visualapproach/Volvo-melbus/schematics/8645_4066.png

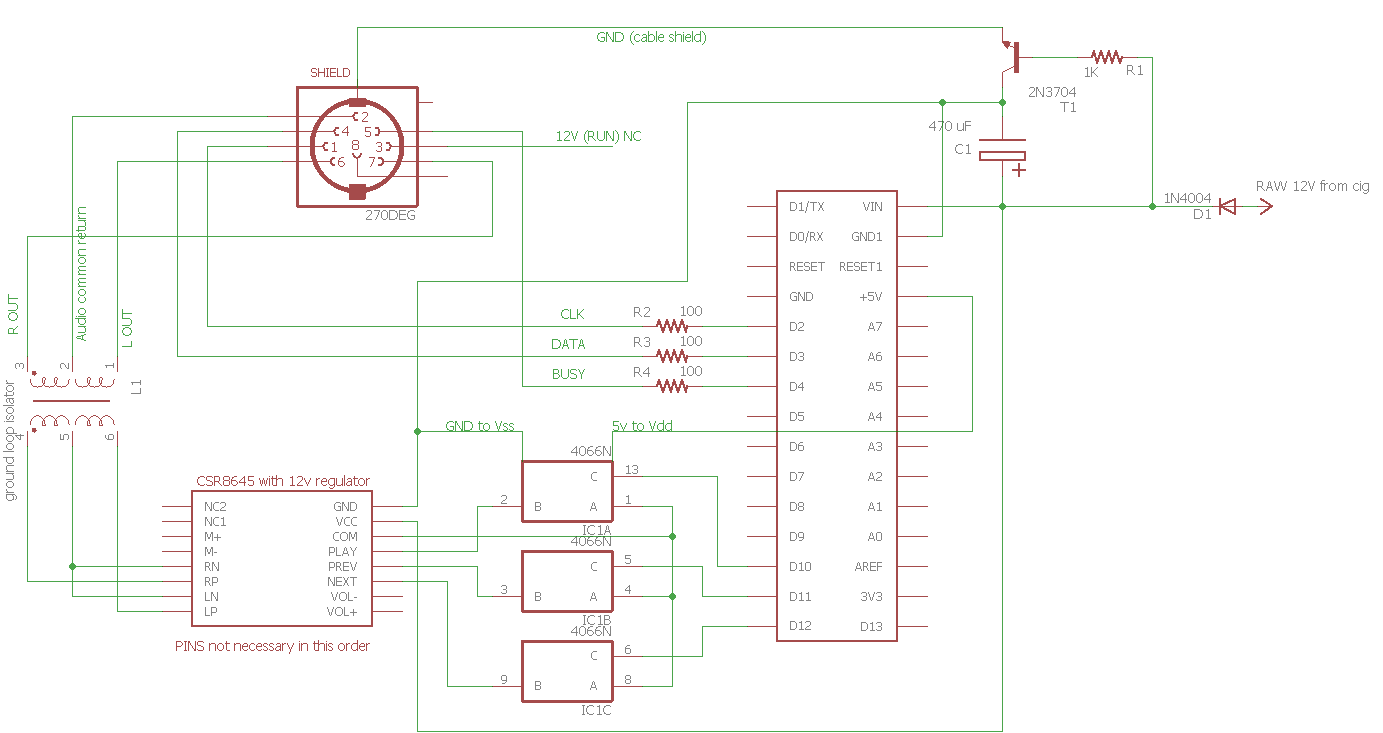
schematics/8645_4066.png
