visualapproach/Volvo-melbus/schematics/uln2003_2.png

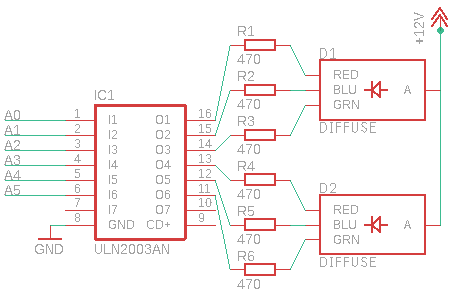
schematics/uln2003_2.png
