visualapproach/Volvo-melbus/(threads)

Thread 2 (2017-03-24):

Some noise present when BT audio is off.

visualapproach, 2017-03-24:
Data transmissions is audible when not playing. I have audio and data running in the same CAT5 network cable.

visualapproach, 2017-03-26:
It appears to be the arduino that is the source of the noise. (It goes silent when resetting the arduino. Remains if I disconnect the audio, wich suggests it is NOT a ground loop problem.) I'll try decoupling the power lines with a cap.

sorano, 2017-03-26:
Nice find!

Såg precis att du uppdaterade fotot, Lol @"fritzing" ;)

schematic.png visar pins 8, 11,12 för BT medans foyot & koden använder 8,9 & 12.
Ska se om det är mycket på jobbet imorgon annars kan jag börja klippa och klistra lite riktig fritzing :) som komplement till fotot.

Är det bakelit pcb du använder?

visualapproach, 2017-03-27:
Tack. Tyvärr hjälpte det inte med en konding. Angående pin-val så spelar det ingen större roll vad gäller att kontrollera BT-modulen (Däremot måste data-pinnarna hamna rätt för de använder interrupt som bara finns på vissa pinnar). Du bestämmer funktion genom att definiera pinnarna i början på koden.
Jag hade ett gammalt experimentkort liggande. Tror det är glasfiber eller liknande. Kopparn är rader om tre hål:
--- --- --- --- ---
--- --- --- --- ---
osv, men det går så klart med andra typer också.

visualapproach, 2017-03-28:
Glömde säga det, men det vore ju jättebra om du gjorde en riktig fritz. Kanske blir enklare för nästa person som vill vara med. Jag har nu åkt till jobbet några dagar och lyssnat på BT-musik. Riktigt nice! Ibland kopplar inte iphonen upp sig automatiskt mot modulen utan man får klicka på "anslut", men sen funkar det bra. Modulen spelar en liten plingplong när den ansluter.

sorano, 2017-03-28:
Har börjat skissa lite i Fritzing nu, ge mig nån dag så ska jag ha det någorlunda ok!

Vet du om BT modulen klarar av [aptX](https://en.wikipedia.org/wiki/AptX )? Har märkt av skillnad i ljudkvalité på BT jämfört med AUX?

visualapproach, 2017-03-29:
Jag har faktiskt ingen aning om aptX. Man måste nog kolla datasheetet för själva chipet och det är lite krångligt när den är i bilen för det behövs i princip ett mikroskop. Jag hör ingen skillnad mellan AUX och BT. Det är ju subjektivt men jag har inget att klaga på vad gäller ljudkvalitén. Jag är nöjd.

mrkiller2010, 2017-03-29:
Haha, sjukt hur jag hittat er som fortfarande kör runt dessa volvos! :) Har en Volvo V40 2001 fas1 med en HU radio.
Köpte en 8pin kabel till aux hona. Fick hem det idag och har inte hunnit att testa det, så måste man göra en interface och använda sig utav kod för att få auxen att funka? :/

Sorry för offtopic

visualapproach, 2017-03-29:
@mrkiller2010
Hej och kul att du hittade oss ;-)
enligt [denna sida](http://forums.swedespeed.com/showthread.php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) så har du en HU som använder MELBUS och dessa måste man lura att det finns en CD-växlare för att de ska öppna LINE-IN. Finns komersiella grejer att köpa, eller så har man inte vuxit ur "kansjälv-stadiet" och värmer upp lödpennan.
Det är ok med off topic, det finns ju ingen allmän chat man kan skriva i vad jag har sett.

mrkiller2010, 2017-03-29:
@visualapproach
Okej, nu är jag med. Men din lösning har även support för BT.
Skulle du kunna länka alla delar som krävs för denna interface? Finns ju alternativ till audrino, skulle det funka bättre?

Det [http://i.ebayimg.com/images/g/DKEAAOxym2BSGzav/s-l300.jpg](här) jag köpte. Fast med AUX hona så jag kan borra i den till själva radion

visualapproach, 2017-03-29:
@mrkiller2010
Först skulle jag testa bara sladden du köpt. Vem vet, kanske har den inbyggd elektronik. Fast jag skulle mäta på den först så du inte kör 12v rakt in i mobilen eller vad du tänkt koppla in. En av pinnarna på DIN-kontakten är nämligen 12v.
Om du ska bygga så läs [readme](https://github.com/visualapproach/Volvo-melbus/blob/master/README.md). Om du inte vill ha BT så ta bort följande komponenter:

3x 560Ω
3x LED's (To drop voltage and look cool)
BT Audio Module

Koppla därefter in ljudsladden till resp pinne på DIN-kontakten. [Länk till DIN pin layout](http://volvo.wot.lv/wiki/doku.php?id=melbus)
Ladda upp koden på Arduinon och så ska det fungera.

Angående Arduino: För att aktivera LINE-IN genom att emulera CD-C så fungerar Arduino (i motsats till vad vissa säger). Det finns så klart en massa andra alternativ, men det är till Arduino jag gjort programmet. Om det nu är Arduinon som orsakar det lilla störljudet innan man aktiverar ljudspelning så kanske det funkar bättre med nå't annat men det har jag inte provat.

visualapproach, 2017-03-30:
@sorano
Fick igång SAT som SOURCE. Det kan innebära en del bra saker...
[readme](https://github.com/visualapproach/Volvo-melbus/blob/master/README.md)

sorano, 2017-03-30:
Coolt 😮 !

Vad står SAT för i detta fallet? Jag antar Satellit då det står Sirius? Varför vill man ens ha tillgång till satellit i sin bil? För satellit telefon? Eller TV om man har skärmar?

Hoppas du hittar något intressant 😃

visualapproach, 2017-04-01:
I got rid of 90% of the noise by driving the AUX (on the BT module) to GND via two resistors (Between 100 and 600 Ohms would be fine. I tried with 240 Ohms)
red---resistor---black---resistor---white
Good enough for me, so case closed.

mrkiller2010, 2017-04-30:
Undrar om du kan löda ihop allt om man beställer hem alla delar hem till dig för en slant?

visualapproach, 2017-05-07:
@mrkiller2010 Det blir inte lönsamt för någon av oss. Skillnaden mellan en kommersiell produkt och denna är bara några hundralappar som ska täcka både jobb och frakt.

mrkiller2010, 2017-05-09:
@visualapproach Hejsan!
Har precist beställt allting som du skrivit på listan, var tvungen och köpa flera stycken på vissa som resistor, LED, och dom där små sakerna.

Skulle du kunna skicka flera bilder på bygget? Vill se hur allt är lödat fast. tack

mrkiller2010, 2017-05-09:
@visualapproach Förresten, vad heter den där gula plattan allt sitter på? lär ju beställa en sådan också?

visualapproach, 2017-05-10:
@mrkiller2010 Det är en experimentkort. Det finns massor olika modeller och det spelar ingen större roll vilken du köper. Det finns billiga i papper med koppar på baksidan, men de är lite jobbigare att löda. Sen finns det lite dyrare i bakelit/glasfiber etc. Sök på "prototype experiment pcb" så hittar du massor. Ta en modell med 0.1" hålavststånd (2.54 mm) och som har tre-fyra hål per "ö". Dvs kopparn förbinder tex tre och tre hål. Då är det lättare att löda fler kablar till samma PIN osv. [exempel](http://www.ebay.com/itm/10Pcs-DIY-Prototype-Paper-PCB-Universal-Experiment-Matrix-Circuit-Board-8-5x20cm-/131047274580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)
Angående bilder på bygget så har jag monterat allt i en plastlåda som är jobbig att skruva isär. Är det nåt specifikt du vill veta så kan jag nog förklara.

visualapproach, 2017-05-10:
Ett tips när du bygger ihop allt: gör en anslutning så att du kan ta loss modulen utan att behöva demontera bilradiopanelen varje gång. Som du ser på mina bilder har jag ett antal små kontakter (kräver specialtång för att crimpa dit på kablarna), men man kan också skarva nätverkskabeln med tex en hanDIN+honDIN.

mrkiller2010, 2017-05-10:
@visualapproach Hejsan. köpte det du länkade precis.
Det jag undrar är hur allt är lödat, typ vilka kablar osv men det löser sig nog när jag får hem allting.
Detta är enbart bluetooth eller hur? Såg att du skrev att man kan enkelt koppla aux till blueetooth enheten och fixa det på det sättet?

Och vad menar du med att fixa en anslutning? Jag ska ju löda ihop allting och slänga in allt i en liten låda med sladd ut till själva MEL Bus porten till radion?

visualapproach, 2017-05-11:
@mrkiller2010 Hej, AUX ska bara vara att plugga in med medföljande sladd. (Minikontakt i BT-modulen som slutar med lösa kabeländar, så du kan koppla på valfri AUX-kontakt.) Med anslutning menar jag att skapa ett enkelt sätt att koppla loss plastlådan. Säg att du måste löda om något, då är det enklare att koppla loss boxen och gå och löda, än att riva ut stereon för att koppla loss den. Och bättre än att sitta i bilen och löda ;-)
En annan grej du kan tänka på (som står i schematics) är att jag blev av med det sista oljudet genom att INTE koppla in AUDIO GND. Lycka till med byggandet!

mrkiller2010, 2017-05-12:
@visualapproach Tackar för tipsen. Har du lyckats fixa custom text? Skulle vara coolt om man kunde ändra så att det står låtens titel eller BT/AUX på radion.

visualapproach, 2017-05-17:
Det vore jättecoolt men jag har inte forskat något mer. Det krävs nog att man sniffar en satellitradio för att lyckas. Lite svårt att gissa sig fram.

mrkiller2010, 2017-07-05:
Hejsan!
Har fått hem allting och jag har börjat löda ihop modulen.
Är inte riktigt klar men undrar vart två tråds sladden som sitter i BT chipet ska lödas fast samt.

Tror dessutom att jag lött helt felt men vi får se..  :/

visualapproach, 2017-07-05:
Kul! Du ser på bilden i readme vart den ska sitta i bt-modulen. Observera fel färgkod på sladdarna, så svart=+12v och röd = gnd. I alla fall är det så på min. Andra änden: svart direkt på Vcc(12v) och röd (gnd) på transistorns kollektor. Lägg upp ett foto eller skiss här om du vill ha stöd innan du kopplar in.

mrkiller2010, 2017-07-05:
Är trött på skiten haha.
Har du lust att hjälpa till med lödningen? är i stort sett klar, bara nätverkskabeln till 8pins anslutning samt till själv arduino och bt chipet kvar.

mrkiller2010, 2017-07-05:
Såhär långt har jag kommit, http://imgur.com/a/F5gko Det är säkert helt fel komponenter jag använt samt lödat fel haha.
Ska försöka löda ihop resten imorgon och se om skiten fungerar vilket jag tvekar på.

mrkiller2010, 2017-07-06:
Fan det är omöjligt o få nätverks sladdarna på 8pins skiten, råka smälta skiten så pinsen e sne nu :/
Har en till 8pins connector men vill ej göra den då jag inte kan. Sen så fattar jag ej hur jag ska ansluta nätverkskabeln till själva bt modulen o det.

har du inte lust o hjälpa mig om jag skickar allting hem till dig?

visualapproach, 2017-07-06:
Var bor du?

mrkiller2010, 2017-07-06:
Bor i Gävle

visualapproach, 2017-07-06:
Ok lite för långt. Jag jobbar men skriver mer ikväll. Som tröst kan jag säga att jag också smälte den första kontakten. Man får vara snabb och inte ha för hög värme eller för stor lödspets. Det bästa är om man har den inkopplad i en hona så stiften sitter fast medan man löder.

mrkiller2010, 2017-07-06:
Hur många timmar ifrån mig bor du om man åker med bil?

visualapproach, 2017-07-06:
6-7 skulle jag tro

mrkiller2010, 2017-07-06:
Kan annars skicka hem allting till dig, och du hjälper mig med det som är kvar? Står för porto och allting.

visualapproach, 2017-07-06:
Hann tyvärr inte kika på detta ikväll men ska göra det så fort jag får tid.

visualapproach, 2017-07-08:
@mrkiller2010 vilken email har du?

mrkiller2010, 2017-07-08:
@visualapproach dyar.98@hotmail.com

Closed 2017-04-01.

Thread 3 (2017-03-24):

HU is commanding power on repeatedly

visualapproach, 2017-03-24:
This isn't a problem, but annoying when sniffing the data line.

sorano, 2017-03-30:
Jag funderade lite på detta.
Kan det inte vara så att HU vill ha någon typ av "ack" acknowledgement som verifierar att enheten den söker är igång, och då slutar skicka HU skicka "power on"?

visualapproach, 2017-03-31:
Jo det är helt riktigt. Själva "powerup"-meddelandet ska ackas med en byte. Jag har provat alla svar (0-255) utan att märka skillnad. Tror att man måste hitta rätt i antingen CartridgeInfo (6 bytes) eller i TrackInfo (9 bytes). Det är dock lite jobbigare att testa brute force på så många bytes. (6 bytes = 256^6 = 281 biljoner kombinationer. Trackinfo är lite färre okända bytes.) Men när jag orkar tänkte jag göra ett mer interaktivt program så jag inte behöver kompilera om för varje ny kod, och så kan man kanske få fram betydelsen av fler bytes.

visualapproach, 2017-03-31:
Actually, I found an answer here on github. Maybe. I'll have to check...

visualapproach, 2017-04-01:
The answer was found here: [code](https://gist.github.com/klalle/1ae1bfec5e2506918a3f89492180565e)
Case closed

Closed 2017-04-01.

Thread 5 (2017-03-24):

Back powering through audio GND

visualapproach, 2017-03-24:
Need to think of a way to block back powering through audio GND. Not a big deal, but it's annoying that the arduino power led is glowing faintly when car is off.

visualapproach, 2017-03-26:
Solution: ground loop isolator.

Closed 2017-04-01.

Thread 6 (2017-03-27):

AUX & BlueTooth?

sorano, 2017-03-27:
What would be the best course of action if you want to use an AUX connector along with BlueTooth?

Connect AUX to the BlueTooth module or piggyback the cables to DIN?

visualapproach, 2017-03-27:
I'd connect it to the AUX on the BT module. It's supposed to automatically switch to AUX input when BT is quite (or not connected. The "manual" is sparse to say at least.) There is also a MIC input on the board, that I guess could be used to speak on the cellphone. I have a VOLVO corded Telephone installed so I haven't tested it :-D

sorano, 2017-03-27:
Will try and report once I get my module.

mrkiller2010, 2017-05-10:
@sorano Hello, Did you manage to get AUX input working as well?

Closed 2017-03-27.

Thread 10 (2017-07-11):

chat

visualapproach, 2017-07-11:
put your comments or questions here

visualapproach, 2017-07-12:
Check the cables extra carefully that comes with the BT Module! Red and black power wires may or may not be reversed. I've seen both...

rysatko, 2017-10-17:
Hello Thomas.
First of all I would like to thank you for your work. This is awesome project.
I tried to make my own dongle (for now only AUX-in, CSR8645 is on the way from china). But I managed to work it only once - both SAT and CD-CHGR. Then it showed SAT ERROR and since that time my HU850 (with 6CD built in) does not recognize it. I tried all your SW versions and also SW from Vincent, but no luck. Could you please go through the troubleshooting with me? When I open serial monitor, it tells only "Calling HU" and then plain lines only. After uploading Vincents SW it tells "not in sync".
HW side should be fine. I measured all connections several times and everything is OK.

visualapproach, 2017-10-17:
Hi and thank you for joining!
My first guess would be the power supply. The car electric power is very noisy and that can cause problems. I had some communication errors too when I switched from using the RUN wire as power supply to using 12v from the cigarette lighter. It was solved by NOT using the cig lighter as a GND-point, but using the shielded cable's shield. See picture below. The reason I didn't use RUN is that it couldn't deliver enough amps for my project. At least not consistantly. In the pic below I haven't included protection against backpowering. It can be done with a resistor and a transistor (see master thread) or several other ways. I really recommend the ground loop isolator also. It is worth the money (I think 20 €-ish)!

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

rysatko, 2017-10-17:
For now my HW is built exactly iaw the drawing in master thread. So I am taking +12V from RUN and it is grounded by pin #2. Plus I added 8205 voltage regulator because the regulator on my chinese Arduino seems a bit crappy and I measured only 2V on the 5V pin. So I hope that the solution is so easy as you suggest. I will let you know asap. :)
Btw. ground loop isolator is also on the way.

visualapproach, 2017-10-17:
Fingers crossed :-)
I think you could try to power it with a powerbank via USB. (Easier than resoldering stuff for a test)

I wonder if it's the voltage regulator or if RUN is not coping...

rysatko, 2017-10-17:
So it is connected to the lighter socket. But no change for now. I am taking my computer to the car and we will see..

rysatko, 2017-10-17:
Nothing again. HU does not recognize it. :(

visualapproach, 2017-10-17:
Ok... did you try driving the arduino from the computer ONLY? (Disconnect 12v cig and 12v  RUN, and connected GND through DIN cable)

visualapproach, 2017-10-17:
Do you get any text except "calling HU"? If not then I suspect the main init sequence is not performed successfully. Maybe it doesn't pull the busy line low enough? And confirm your arduino is 5v 16MHz. The 3.3v 8 MHz won't do. It might be helpful if you post some pics on your device.

rysatko, 2017-10-17:
I am sure, that it is 5V arduino. As I told you, it worked for 2 days. I can see text "calling HU" in serial monitor. Now I am going to desolder GND and take it to car again, this time powered from powerbank only.

visualapproach, 2017-10-17:
Ok. It can be really frustrating and take a lot of time finding what's causing the trouble. But since it has worked something must have happened. Which means it is not likely software. So either something broke physically or electronically. Several times I have been certain it was a bug in my program, but it always ended up beeing a loose wire, or bad ground or similar. It's difficult to say what's wrong in your case and all I can offer at this point is some generic recommendations:
-check voltages and resistances with a multimeter (like is 12v OK even when under load? Same for 5v. Is GND resistance to HU chassi almost 0 Ohms? Recheck DIN connector, it's prone to bending and in a tight space there is a risk of shorts.
-make another visual inspection of the cables. Look for shorts or open circuits in the cables and under/over the PCB.
-do not use extremely long wires/cables.
-when in doubt, reduce to simplest possible circuit and check functionality. (only arduino, powered from battery)
-get a couple of beers and sleep on it. Repeat this step if necessary.

rysatko, 2017-10-17:
The last step would be the best :D
No succes with power only from USB. Only "conn" or "calling HU" messages.
To go through hints you gave me:
- Resistances checked, everything is fine. Voltages not yet, only on table when powering it from 12V PC power source - was ok. Bending of DIN is not my case, because I am trying it with HU pulled from dashboard.
- I have done inspection for shorts with ohm meter - ok
- Longest wire is approx 0,5m cable to DIN and 1,5m audio cable (does not matter)

Maybe I can try to buy another Arduino and try it again.

When I think about it, I have bought AUX/USB/Bluetooth box from china and I also had issues with it. Sometimes it worked, but mostly not. This was why I wanted to build my own. Maybe my HU constantly has its days. :/

visualapproach, 2017-10-17:
Yes maybe it's the HU, I have a 650 myself. No play in the HU connector? If you wiggle it I mean. Anyways, you should see almost 5 v on the data/busy/clk-lines at the arduino side when you measure, and 12 v on RUN. If you don't, you know the problem is either your HU or the cable. If possible you should measure this first with arduino disconnected (because it pulls the lines high) If this is too cumbersome you can upload a sketch that tristates D2-D4 (pinMode(2, INPUT))
I really wish you good luck now, and keep us updated on your progress!

rysatko, 2017-10-17:
I will try the code with input pins on D2-D4, because Arduino is soldered to prototype board and it would be pain in ass to get it off. I can also build second cable, but it is nonsense. I will try it on Thursday (if I will not be in work till night :D ).
Also the Arduino could be bad. As I told you, the voltage converter on it is quite tricky and when I powered it directly from 12V, the LEDs on it lit only slightly. That time when I powered it with 5V from NTB or via 8205, it worked like a charm.

Thanks so much for your time and kindness. I really appriciate it. ;)

rysatko, 2017-10-28:
Hello again.
I finally tried it. I'm not at home and I forgot to take USB cable to upload modified software so I tried to disconnect GND cable from the whole box (in my opinion it should work too, but maybe I am wrong). I have got 3V on D2 and D4 and 4,5V on D3.

visualapproach, 2017-10-28:
Hi again! Hang on and I'll check what my DIN output measures at the end of the cable...

visualapproach, 2017-10-28:
Yes, As I suspected I measured 4.7 volts at all three lines (In car, arduino end of cable, disconnected from arduino. I have an extra pair of DIN plugs so I can easily remove the device from the car). So I think you've traced it to be either your cable, or your HU. Next step would be to remove the cable and measure on the HU itself.

rysatko, 2017-11-04:
Finally a day off - HU measured. RUN - 11,26V, DATA and CLK - 4,57V, BUSY - approx. 4,5V (fluctuating between 4,42V and 4,58V. Now I will try to desolder the cable from my board and try it again. The cable is 8x0,25mm2, connector is standard solderable 8-pin DIN 270°.

visualapproach, 2017-11-04:
Good! It is a good thing that your HU is healthy. It is much easier to fix the cable. I use a shielded network cable with 4 twisted pairs in it. I had to run GND through the shield, rather than the GND at the cig connector, to get rid of alternator noise. (See image in this thread). I wish you luck!

rysatko, 2017-11-04:
Connector checked and soldering is rock solid. So I desoldered BUSY, CLK and DATA at the side of Arduino and measured once again. And I found out, that when I move with the cable at the HU side, voltage of BUSY is droping to 0V. This is a hope :)

visualapproach, 2017-11-04:
Yay! Bad wire? Great find! Intermittent faults are tricky to hunt down.

rysatko, 2017-11-04:
I changed the wire aaand... Nothing again. :/ It is still losing connection. I think the problem is in the connector. But even if I tried to hold the cable in position where it appeared to be OK, nothing happened. HU still refuses to cooperate. I think I will get another Arduino and I will give it one more try...

visualapproach, 2017-11-04:
Is there a point in getting a new Arduino if you know your cable/connector is bad? Of course it doesn't hurt getting some extra arduinos, they're pretty cheap.
Or do you get good readings out of the cable when it's not connected at the arduino side now?

rysatko, 2017-11-04:
I have connection, when the cable goes straight forward or when I push it towards the drivers side. I tried to connect everything together and HU stil does not see any new device. For now I know the voltage converter on Arduino is bad. It is few years old and was used for several projects. It cost me about 3€. Maybe there could be also problem with the 8205...
I will build new board without the backpower protection and we will see. Just a question - what is the capacitor C2 at the drawing you posted at the beginning? I ve got only C1 - 470uF

visualapproach, 2017-11-04:
Oh, c2 is a small ceramic cap. I put it there with the purpose of filtering noise when I had some issues. You can omit it. The big cap can be considered more of a local powerbank to survive short voltagedrops.

rysatko, 2017-11-11:
I'm starting getting frustrated. Today I gave it a try. New Arduino, new cable and new simple board. When I was measuring connections between HU and board, I found out, that I do not have voltage at CLK pin. Even if I try to measure it directly in the HU connector, I cannot see anything...

visualapproach, 2017-11-12:
That sucks! I can't really give you any advice on how to fix that. Sorry. But I'm feeling your frustration!

rysatko, 2017-11-12:
Now I am just thinking... I have only connected DATA, BUSY, CLK and GND lines into HU. Pins for right and left audio and GND on pin are free. Have you tried this setup, when you were developing your board? Maybe HU shuts off CLK, when some of those 3 are free? I did not try to connect any load to them when I was measuring this time. And I do not remember, if I connected them when I was measuring the time before.

I am just cooking from water, before I get courage and time to remove HU from car and start disassembling it. :D

visualapproach, 2017-11-13:
@rysatko I measured 5v on DATA, BUSY and CLK directly on the HU connector. Nothing connected at all.

PedroPiko, 2017-11-21:
Hello Thomas,

First of all I would like to thank you for your work. This is very interesting also to me. I have tested on HU-603, which has not SAT mode. So I changed the CDC to MDC base, response IDs and now I running with MDC (buttons not tested on Nano outputs) but except text seems that is running OK. I have debug it with serial and found that MBR2 is there but there is no text in MDC. Do you have any idea how to enable it: Thank you. Peter

visualapproach, 2017-11-21:
Hi Peter!
Thank you. My 650 doesn't support MDC, I think. So I have no means to investigate it by my own. @VincentGijsen and I managed to 'crack' the SAT messages between his 3rd party commercial device and the HU by using a logic analyzer and a lot of testing. I have a logic analyzer but nothing to analyze. If he reads this he MIGHT be able to sniff some more?
My guess is MDC messages are equal or less complicated to understand than SAT though.
To enable MDC text you would need to:
- record and analyze communication between a MDC (real or emulated) and HU. (Theoretically one could try to answer the HU without this recording, but it would take too much effort and time. Number of expected bytes in the answer is known, but not the expected content.)
- Add support for new commands from HU, along with proper answers.

Regarding the MRB2: I reckon you are requesting master mode as MDC and the HU grants it by sending out a master request broadcast to every device connected on the Melbus network. You then have to listen for MDC ID and respond with ResponsID. That's the easy part. Immediately after that you have to send some data. Most likely different from CDC and SAT, so you can't just send data as were it a SAT device.

Cheers / Thomas

VincentGijsen, 2017-11-21:
Hi Peter,

As Thomas said, we sniffed using a hu850 (popup screen in my case) .

As the aftermarket unit supposed to use SAT-mode with this radio, I sniffed only that. I guess the mechanism will be similar on MD, but as the sat has perhaps more options, it might have a more complex initialization mode. Perhaps when i have some spare time in the coming weeks, I might put the MD firmware on the unit and see if I can record a initialization. But I don’t know if the 850 will query the device at all.

Cheers

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

visualapproach, 2017-11-21:
Hi Vincent! Nice to hear from you again. Very kind of you to reply. Hope you have a good time!

PedroPiko, 2017-11-21:
Thomas, Vincent,

Thank you for info and support. I have also logic analyser, but nothing to analyze too 👎.I will try to find something on the net.

Peter

visualapproach, 2017-11-21:
Some guys asked for MD info on this page: [https://gizmosnack.blogspot.se/2015/11/aux-in-volvo-hu-xxxx-radio.html](url)
Perhaps they found something out by now and are willing to tell you. And then you post your info here ofc :-)

PedroPiko, 2017-11-22:
Thomas,

I have started with that project (gizmosnack) and ended up with this. I went trough all the related projects and have found some guys that have found solution for text in MDC mode. Most of them turn to commercial so they would not to share the code. Anyway I will try to carry out some tests.

Peter

visualapproach, 2017-11-22:
Yeah I thought so but it was worth mentioning. If you or vincent gets any data logged you are welcome to post it here for people to analyze. If it is large amount of text please start another issue to keep this chat human readable.

erinel01, 2018-02-11:
Hi!
I went with your old schematics, ver 2 but i get + from the lighter socket and ground from the shield of the DIN, signal-ground I take from pin 2 in the din.
I have a ticking sound that is the same rythm as the led on the arduino. It´s present regardless if I have the BT-module connected or not. Anyone have a suggestion what to look for?

visualapproach, 2018-02-11:
Hi,
I never got rid of that until I switched to CSR BT module. At the same time I also installed a ground loop isolator. Never tried that on previous bt module. The ticking was only heard at high volume during paused music though. I think it’s crosstalk in the cable between the data lines and audio lines. Now that i’m thinking about it my audio lines is going through the GLI outside of the DIN cable, joining at the connectors. Don’t know if that routing makes any difference. But my system is free from noise now.

VincentGijsen, 2018-02-11:
A groundloop isolator does help alot, also i wiredup the Ground from the din to powersupply Ground.

Furthermore i had Some issues with with poweramp on the csr board, which tripped some brownout threshold during ignition from an ams1117 regulator, so I switched the csr board via an transistor after a second. Steady as a rock :)

Btw the CSR is totally awesome in terms of audio quality, but unfortunately no ACRP 1.3 (uart and metadata)

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

johan489, 2018-04-23:
Hi,
Quick question, what type of groundloop isolator are you using?

Cheers

johan489, 2018-04-23:
Thanks,
Starting assembly soon, waiting for a few parts.

On Mon, Apr 23, 2018 at 2:14 PM, visualapproach <notifications@github.com>
wrote:

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

j-ak-e, 2018-06-13:
Hey @visualapproach I just discovered your project when reading https://gizmosnack.blogspot.com/2015/11/aux-in-volvo-hu-xxxx-radio.html

Did you ever get custom text working? Could I help with custom text at all?

visualapproach, 2018-06-14:
@j-ak-e yes sending text to HU display is working fine :-)
It's all in the code, with comments.

visualapproach, 2018-06-14:
@j-ak-e that is, if your HU can select SAT mode. For MD mode no work is done. Needs data sniffing from a real or 3rd party device.

j-ak-e, 2018-06-14:
@visualapproach I get my V70 in a couple weeks, so I'll make a breakout cable for the accessory port and sit in the car debugging, I'd be able to sniff data but I don't have access to a device unfortunately

visualapproach, 2018-06-14:
@j-ak-e Me neither.

j-ak-e, 2018-06-20:
@visualapproach I'm trying to lay out a PCB to make a small batch of these (~10), did you ever find part numbers for the DIN sockets/plugs?

johan489, 2018-06-20:
I would be interested in buying one if you do.

Johan

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

VincentGijsen, 2018-06-20:
Will you ADD a Bluetooth module, ifso, i Can recommend an csr module. Great sound quality. But if you pick a slightly more expensive module, you can can also get the metadata over serial. And write that to screen.

Kind regards,

Vincent

Sent from a mobile device

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

visualapproach, 2018-06-20:
@j-ak-e

just google "DIN plug, 8 pin, 270 degrees". The cheaper ones requires more soldering skills because the plastic easily melts. If you buy some females, solder while male-female is joined, to secure the pins in place.

j-ak-e, 2018-06-20:
@visualapproach It was for the PCB layout, I've found a couple of working parts, so I'll use them, currently waiting on my EDA guys to design the footprint, and some money to come in to order boards

dancek, 2018-06-24:
Hi! Just wanted to say thanks for sharing your code. I soldered a simple cable (with 3.5mm plug) for my HU-803 and this code  works nicely.

I'm thinking about porting the relevant code to Rust on ARM for practice. That is if I find enough motivation to figure out all the voltage level conversions...

visualapproach, 2018-06-25:
@dancek I appreciate that you share the success with us! Well done! I know nothing about rust, but I think you have a lot of room for prettyfying the code with that kind of horsepower. From the top of my head, there should only be three lines to level convert. Busy, data and clock.

j-ak-e, 2018-06-25:
@visualapproach (or anyone else with a module that has in-built power regulation), could you figure out what voltage I should be supplying the chip, and on which pin, if not using a module with regulator? Do I provide 1V8, 3V3 or 5V to VBUS?

visualapproach, 2018-06-25:
@dancek which chip are we talking about?

j-ak-e, 2018-06-25:
@visualapproach assuming that was directed at me, the CSR8645

visualapproach, 2018-06-25:
You assumed right ;)
There are several variants of breakout modules. Mine was with a 12v input IIRC. Some appears to require 3.6-6.5V. If you are using a bare chip i don’t know. A google search suggested max 3.3 V but you’ll have to research that. Or wait for a more educated answer.

j-ak-e, 2018-06-25:
I'm planning to use this: https://www.banggood.com/CSR8645-4_0-Bluetooth-Stereo-Audio-Module-Low-Power-Consumption-Supports-APTX-p-1104609.html but the only specs they provide are for the battery. If you get chance, could you measure the voltage between VBUS and GND on your module @visualapproach ?

VincentGijsen, 2018-06-26:
I use such a module without  12v part. I just added a ams1117 3.3v regulator. The amp on the board has some issues powering up sometimes, so I connected it’s power via npn and digital io , so I can reset the board and do a delayed start.

If you spend a few bucks more, you can buy something like https://www.silabs.com/products/wireless/bluetooth/bluetooth-classic-modules/wt32-bluetooth-audio-module

Way more Bluetooth control and metadata access :)

Kind regards,

Vincent

Sent from a mobile device

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

darjusp, 2018-10-27:
Hi guys, thanks for the promising project, i was always searching for the way to push the text into Hu-650, its a missing, but very crucial part of bigger project. I have few questions, maybe you could give some hints for me:
- Are all HU-650s have SAT mode or only US market? i have european, thus is it worth trying this project?
- I don't need to connect any bluetooth to it only deal with Text and catch button presses, which of the .ino files would be a good starting point as there are several ones?
- How many buttons i could manipulate from the HU? right button (source select), RND, >>, <<. Is it possible get values of Volume knob or some other not mentioned buttons?

wishes

visualapproach, 2018-10-27:
@darjusp Hi there! Any of the two files in code/ will do. The newest is https://github.com/visualapproach/Volvo-melbus/blob/master/code/SAT_CDC_for_PCBv2.ino
My European HU-650 have SAT mode and you can recognize following buttons (from the code):

#define PUP
#define PWR_OFF
#define PWR_SBY
#define IGN_OFF
#define BTN
#define NXT
#define PRV
#define SCN

BTN is 1 through 6 on the HU. Steering wheel >> and << is the same as BTN #2 and #6, RND is a special button which I don't think is recognized in SAT mode.

Good luck

visualapproach, 2018-10-27:
and MAYBE volume up/down (not implemented in SAT but it should work in CDC)

darjusp, 2018-10-27:
Great mate, thanks a lot for the prompt reply. Will try my luck soon :)

smithdc1, 2018-11-24:
This is a great project. I've been building my module up in fits and starts for a while and today I finally completed and went for the install.

My Arduino is powering up but I'm not getting any extra display (cd-changer) on the head unit. I've double checked the connection from pins d2 - d4 and they have a resistance of 100ohms to the pins on the socket. I'd have thought that's all I would have needed to pass this first test. I installed the software from about a year ago onto the Arduino. Appreciate your thoughts.

VincentGijsen, 2018-11-24:
Did you swap pins? Some pins might not support 'external interrupt'

And earthing / power? How do you power the arduino?

Does the arduino react to the ready pin?

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

smithdc1, 2018-11-24:
> Did you swap pins? Some pins might not support 'external interrupt' And earthing / power? How do you power the arduino? Does the arduino react to the ready pin?
> […](#)
> On Sat, 24 Nov 2018, 16:51 smithdc1 ***@***.*** wrote: This is a great project. I've been building my module up in fits and starts for a while and today I finally completed and went for the install. My Arduino is powering up but I'm not getting any extra display (cd-changer) on the head unit. I've double checked the connection from pins d2 - d4 and they have a resistance of 100ohms to the pins on the socket. I'd have thought that's all I would have needed to pass this first test. I installed the software from about a year ago onto the Arduino. Appreciate your thoughts. — You are receiving this because you were mentioned. Reply to this email directly, view it on GitHub <[#10 (comment)](https://github.com/visualapproach/Volvo-melbus/issues/10#issuecomment-441376790)>, or mute the thread <https://github.com/notifications/unsubscribe-auth/AAsEY8LpiRgateC5SYZgXfGLgz2T-AZjks5uyWr9gaJpZM4OUphm> .

I've kept the pins the same as the schematic diagram, power was from the 12v cigarette lighter. Arduino / bluetooth module power up (and i can pair my phone with the bluetooth module).

The arduino doesn't do anything other than the power light switch on. I'm not sure what you mean by reacting to the ready pin?

VincentGijsen, 2018-11-24:
One of the pins of melbus is know as ready pin, but it might have been
'busy'..now I'm thinking of it. Its purpose is to sync clock signal and
data.

The fact that Bluetooth works cab be ignored, as its the arduino that
matters.

Did you check how your grounding is setup.

I guess adding a few serial.print statements would help figuring out it
your code is reacting to the external pins. Otherwise a logic analyser
would help.

Is your headunit a hu-850?

On Sat, 24 Nov 2018, 17:45 smithdc1 <notifications@github.com wrote:

> Did you
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

Thread 11 (2017-07-11):

ideas

visualapproach, 2017-07-11:
Give the Arduino the ability to reset the BT module. This could be done by an output pin driving a transistor to turn ON/OFF VCC. This could be useful sometimes when the iPhone messes up the sound quality.

visualapproach, 2017-07-11:
Instead of voltage dropping LEDs, you could just use a voltage divider with two resistors.

Thread 12 (2017-08-09):

Text

VincentGijsen, 2017-08-09:
Hi,

Just wanted to let you know I just purchased a 2nd-hand IMIV, as I realy disliked al the secrecy regarding the text-part, so when it is send, i'll sniff the hell out if it, for my kodi-based carpc.

So expect some new insights shortly

Cheers, and clean program. Just a sugestion, in order to not block the melbus to long, a ISRtimer which replaces the long delays in the functions would be nicer, perhaps i'll for a version and implement it.

visualapproach, 2017-08-10:
Sounds great! Looking forward to some open info on the subject. From what I've read about those adapters, they appear to use MD/MD-CHGR to send text. Unfortunately I have a HU-650 which don't let me simulate MD. It's got Ok sound but it appearently lacks support for anything but CD-CHGR and SAT radio.

Regarding the code - thanks for your words!
I guess your referring to the functions "next song" and so on. I agree to that delays aren't the prettiest solution, but I don't think I'm stalling the melbus lines. Possibly missing out a message but the lines are generally not driven while waiting. I intentionally turned off timer0 (used for delay() and other timing ISR's.) because it might interrupt the communication. Although I think it will work with the timer turned on anyway since interrupts are turned off at the most time-critical parts of the code. The function delaymicros() doesn't depend on timer0 if delaying < ~1400 us. It would certainly be easier to make other time-related stuff with timers on. Do give it a try!

Thanks for posting!

VincentGijsen, 2017-08-12:
Hi @visualapproach ,

as promised: https://github.com/VincentGijsen/melbus-sniffed-traffic

i'll continue to post more captures and deducted information.

VincentGijsen, 2017-08-17:
Hi @visualapproach. I took your code, and flashed, hookedup my logic analiser in parallel.
guess what, the first cmd, doesn't recognize the 0xC7 when its due... so therefore it doesn't fill in the blanks

visualapproach, 2017-08-17:
I'm glad you also put effort into this! Together we might crack this! Now, can you tell me more about this? What cmd are we talking about. I guess, since you say 0xC7 that it is the master request broadcast? You saying that the arduino don't answer that? Or don't answer in the correct time? The arduino is definitely getting the master req broadcast and is sending an answer. But it might not be accepted by the HU. Please tell me more :-)

VincentGijsen, 2017-08-17:
Indeed the Arduino doesn't reply after byte c7 has been called, it just logs 0xFF (as the Arduino is to late at T==3 to decide to fill in the bytes.
It might be the whole-lot of init/reset-stuff just before the main while();

My guess is, that it's to slow or in between bytes. that while assessing, its bytecounter == 4, whilst its should be 3.

This might be due to the rather long command-list, by the time its evaluating the first statement, it might already be at byte 4?.

I think we might fake it with  a 'special' case for the master-request, that when it's requested, we first stick some ms in the loop() to catch the 0x00 command for sure, although it might be ugly.

The other way, would be to nest while loops with the cases (on the ordered tree of commands), this would add an increase of speed, so it only has to evaluate the valid succeeding variants. But it would be far more messy...

In the meantime, i might port the code to a STM32, which has considerable more horsepower, which considering a busspeed of 10/12mhz with a 16mhz cpu, is cutting it close

visualapproach, 2017-08-17:
About the STM32; I have one ready just in case. The initial goal for me was to show that a "slow" arduino could do it if you (ab)used it properly (not saying my coding is proper in any way, but it did the trick). Now I reached that goal for CD-CHGR, and with the more demanding SAT maybe it's time to reconsider the hardware. But it would be cooler to do it with an arduino.

I have several versions of "special case" and looping prior to what I posted here. It might be faster but it was so ugly that I couldn't understand it myself after a while :-D

VincentGijsen, 2017-08-17:
I guess, its going to be, ugly loops or more horsepower. Perhaps moving the byte-compare logic to the interrupt handler to synchronise the checks, bit still, its a tight squeeze

visualapproach, 2017-08-17:
It may be wise to develop with horsepower and when it works it might be portable to a pony.

visualapproach, 2017-08-18:
Update: I got custom text in the display!! Working on improvement now.

archi, 2018-07-20:
Nice work. Just a small note: The HU-650 should accept the MD-CHGR. At least mine does with my attempt at an emulator (https://github.com/archi/melbus - that code only gets past the second init, but fails to properly reply with Disc/Track info. Probably the clock gen). I believe even the HU-403 I used as an indoor test device accepted it (not 100% sure, didn't work on this since 2.5 years)

hu601, 2018-07-27:
great work u guys. i previously used Karl's code but wanted text..but i can't seem to get the text working on my HU-601..

visualapproach, 2018-07-27:
@hu601 thanks, what is not working? Trying to help but your info is a little vague ;). Does your HU accept SAT mode at all?

jurgislipsnis, 2019-10-28:
Maybe someone have working code for STM32 for HU803 with working text in the display?

HarryBrunt, 2023-09-14:
Would someone mind please posting a link to the code for text to screen using the MD emulation option?  I've successfully programmed a PIC1842 using assembly language to emulate a CD changer but would prefer to tweak it to emulate an MD changer to get text onto the screen of my HU-613 (NB the PIC runs at 32 MHz and assembly is very efficient).  I can follow code in C or pretty much any other language, within reason.

VincentGijsen, 2023-09-15:
Hi harry,I don’t have a car anymore (with right hu) to sniff the traffic. Back then hu-850, which had SAT mode. You don’t happen to live in Netherlands, to hook up the aftermarket stuff and sniff exchange?BrSent from my phoneOn 14 Sep 2023, at 08:59, HarryBrunt ***@***.***> wrote:
Would someone mind please posting a link to the code for text to screen using the MD emulation option?  I've successfully programmed a PIC1842 using assembly language to emulate a CD changer but would prefer to tweak it to emulate an MD changer to get text onto the screen of my HU-613 (NB the PIC runs at 32 MHz and assembly is very efficient).  I can follow code in C or pretty much any other language, within reason.

—Reply to this email directly, view it on GitHub, or unsubscribe.You are receiving this because you authored the thread.Message ID: ***@***.***>

HarryBrunt, 2023-09-15:
I'm in the UK.  I might try following the same protocol as for the SAT unit to see whether I can get text onto the screen while emulating the MD changer, obviously changing the code identifier for the unit.

Thread 13 (2017-08-09):

Suggestion regarding the BT

VincentGijsen, 2017-08-09:
I would use a CSR8645 (its twice the price with headphone amp). but sounds so much better, oh and it supports APT-x and AAC, as well as realy advanced tuning it's noice-canceling, bi-microphones and equalizer. But straight out of the box, it's as easy as your parallel controlling wires.

Next step should be a BT with serial-interface and AVRCP and meta-data. but they start at 20+

visualapproach, 2017-08-10:
Thanks for the info! Good to have options. A search on ebay for "CSR8645" came up with some modules from $6 which is in the same pricerange as my module.

VincentGijsen, 2017-09-03:
regarding text and bluetooth, you need one of the more expensive units, bluegiga, w32i, or melody sw. They start at >25+ and supply an uart interface. the heavy lifting of the avrcp and metadata is handled within these customized csr modules (basically they wrote specifik sw, running in the VM section of the csr-chips). If you want a real challenge, you could take a look at the ADK from csr, but it's not easy to come by, Some Chinese forums seem to have it (if you pay with credits). but I guess it's not as trivial as just buying some of the repackaged/flashed options with an easy uart interface

visualapproach, 2017-09-09:
Ok. I was playing with an xs3868 and it has avrcp "control only". I could see some potential benefits though, in hooking up the arduino via RX/TX to the chip. For example you get the current state of the music: playing/paused. Controlling the PLAY input PIN is only toggling so you must know the starting conditions if you want to know whether the music is playing or not. I also managed to toast the onboard voltage regulators on that chip. That was easy. Perhaps my 8 channel levelconverter sucked the guts out of it :D

JamieEC, 2021-03-25:
Hi All, did you have any luck with a BC127? Or any other of these modules for that matter? I am tempted to buy one as the support looks better than the others despite the price. I want to add fast-forward and rewind options, as well as some hands free phone capabilities

Thread 14 (2017-08-13):

Power supply

visualapproach, 2017-08-13:
It appears the RUN line (providing 12V DC) is not particularly powerful! I got some weird chopping in the sound sometimes. Now I am feeding 12 v from the cig lighter output and no more hickups. Instead I have alternator wining sound, but that should be fixable :-)

VincentGijsen, 2017-08-14:
the alternating sound, is a result to your probable ground-loop. Just buy a (cheap) groundloop isolator, and all your problems are solved. place it inbetween your audio path, this separates the audio signals galvanic.

I put in a small bc547 transistor inbetween the ground and the audio circuit. insert a xKohm resitor to the base, and wire that to the RUN wire, this will turnoff your hardware when the radio is turned off (which protects the battery)

visualapproach, 2017-08-14:
Yes I gotta try that and see if it helps. I might need a big Cap or a coil on supply also. And I'll use the transistor solution there as well (as in the main GND on my schem.) Good point. A shielded cable wouldn't hurt either.
By the way, I'm working in parallel with you on udpating the software according to the info you gave me about the SAT comm. Really glad you came along!

VincentGijsen, 2017-08-14:
Well, i wil incorporate an orange pi (with analogue video) with the rti screen, and would like to use that as a video/audio player.

Regarding the Cap it will probably make for a cleaner signal, but the the bobine/coil will stay present unless you add a groundloop filter (only few bucks on ebay).

Any progress thus far on the text?  I've also noticed that when i put my transmission inreverse, the screen comes up, enabling the (not connected) rear camera. so that's a nice gimick to add as well, just 2 pins on your RTI to add the camera to.

visualapproach, 2017-08-14:
> Any progress thus far on the text?
Not really. I was working on it but I couldn't even get it into SAT mode tonight. And I thought I had a good chance to see bitches with the updated code... (anyone reading this should see Vincent's code to understand what I'm talking about)

One peculiar thing is that in your sniffdump the device responds with 0xC5 in main init. I have only had any success with 0xC6. Can you verify that?

VincentGijsen, 2017-08-15:
Mm you might be onto something.

The dump lists indeed C5 as response to baseID C0. My code responds differently. Which might need correction. I guess I copied that byte form some forum, instead of the dump.

The funny thing though . The code currently in my test file. Does seem to initialize sat partly correct. That is, no error. Although I hear some noice repeating in the speaker, and see retries of a certain command. And no text so far.

Are you also using hu850?

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

visualapproach, 2017-08-15:
@VincentGijsen I'm on a HU650. No RTI or popup screens. I'll stick to C6 when HU asks for C0. It was late when I tried this yesterday and I found some errors this morning which might explain why it didn't work. After merging your code with my own I ended up disabling INT1 instead of INT0. Doh! We have different hw layout so note to self: copy new code to own project, not the other way around.
Note to you: when device is in master mode, you need to provide your own clock!
The timing info in your dump file is very useful! (After converting it to delta time)

VincentGijsen, 2017-08-15:
Hahaha, I all forgot about the clock generation in master mode... that would definitely help. LOL!

And indeed, my pins are slightly different and therefore the interrupt .

I'll try after work

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

visualapproach, 2017-08-15:
I got sat mode to work again. I found a logic shortcoming in the code. I'll post an update but I first want to get my mastermode not to lock up...
You mind sharing your sniffing hw setup? Do you piggyback the pc onto imiv/hu?

visualapproach, 2017-08-17:
Alternator sound SOLVED. It was a bad ground connector.

mrkiller2010, 2017-08-28:
Great that you've solved the issue, by feeding the cigarette lighter do you mean connect a phone charger for example or?

visualapproach, 2017-08-29:
@mrkiller2010 Instead of taking 12v from RUN you take it from somewhere else. I made a Y-splitter from the contact behind the cig outlet. Not visible from outside and no chargers needed.

I also tried another BT module (the cheap xs-3868) and it is not as sensitive for noise on the 12v as the module in the pictures. It has other drawbacks though. I'm also waiting for another module to test (see Vincent's suggestion) and hope to get crystal clear sound :-)

2bitmarv, 2019-09-16:
Measuring the voltage supply in my 2006 V70 II shows 14.4V when engine is running. Arduino is working flawless but the BT module with its own 12V isolated supply seems to be burned up since this "ND 1203S-1W" DC/DC converter on the PCB only digests ~12.8V at max. I assume that because short before i mounted the HU-650 i did a final test on my desk with my straight 12V power supply and it worked. After assembling the HU in to my car, the Arduino works fine, but the BT never shows up.

Is the circuit handling this mighty supply? Or does this circuit expect the supply to be almost around 12V?

visualapproach, 2019-09-16:
From memory: the diode from 12v should drop .7V but googling ND B1203S-1W they state input range to be 10-20V. I never had problems with that but there is an option to get a non regulated module and use an external voltage regulator.

visualapproach, 2019-09-16:
Maybe throw in 2 or 3 fat diodes in series before the dc/dc ?

2bitmarv, 2019-09-17:
Took out the BT module and tested it. The DC/DC converter outputs 4.5V on 14.4V input and ist still working. The BT chip-assembling is dead (tested via 3.3V supply directly on the board at the "OBKVIEVG" connectors). Obviously this BT module has no overload protection and died immediately that moment 14.4V came to it. Maybe another point is a load peak that came across.

To be on the save side i will use a adjustable Down-Step DC Converter before the whole board to ensure that only 12V will be served and the Arduino isn't stressed too.

2bitmarv, 2019-09-17:
> Maybe throw in 2 or 3 fat diodes in series before the dc/dc ?

Mmmmh, would another N4004 after the first one before entering the DC/DC do the job? Since this would drop the current another 0.7 Volts.

archi, 2019-09-17:
_I sent this earlier today via mail, but seems it did not make it here, so here is a revised comment_

I thought the HU provides stabilized 12V on the RUN line? Or are you pulling power from the unstabilized 12V, e.g. cigarette lighter (which is at around 14.4V during driving)?
Did you measure the actual voltage?

Also remember the diode on the board should drop the voltage (not current :P) from 14.4V to 13.7V (or 12V to 11.3V if taken from the HU). Just out of curiosity: Can you measure the DC/DC converter's output voltage with 12V and 13.7V input? I'd suspect yours is broken (or at least on the high end of the spec... +/-20% load regulation is not exactly outstanding).

I fried a BT module when I connected my cable the wrong way around; if I still have it, I'll measure its output voltage with different inputs.

Additional N4004 should do the job. They can take up to 1A, and I think I measured something like 60mA for the whole circuit. So no problem adding a few more. The step-down converter seems like overkill to me, and could cause you problems with noise (the cleaner the input voltage, the better).

Ah, also: These modules are so cheap due to the non-existent QA, maybe you just had bad luck :(

2bitmarv, 2019-09-17:
@archi: Hey Sebastian :), thanks for the good work. I really appreciate your PCB! First i was using the jumpered setting and used to connect to the RUN line. But unfortunately my BT module wasn't responding that well (some less blinking but no connection offering). After that i removed the jumpered setting and used my desk power supply directly. The BT module then worked fine.

Tomorrow i will read the values from the DC/DC and post them here. I also will read the green HU harness connector in my car and simulate that with my desk supply to find a stabilized source inside the HU that fits the drawing for the PCB better than the RUN line

2bitmarv, 2019-09-18:
OK guys, here are the results. First i measured the battery in the trunk and it gives me a constant **12.51V**. The i continued with the BAT+ at the harness that directly goes to the HU which shows a solid **11.85V** while IGN OFF. If ON (POS 1) it slightly drops to **11.60V** and which is now the same at the now enabled ACC connector (the one i preferred for supply the board). Now i tried to drop it trough all the consumers in the car by being switched on/off to create more draw. The only remarkable differences occurred while turning up/down the fan. Putting the fan on MAX the voltage dropped to **11.28V**. Fan on MIN was **11.58V**. While the other consumers like seat warmer, mirror- and backscreen-heating only enabled while engine is running no further drops showed up.

After urning on the engine the voltage rises up to **14.4V**. Putting all available consumers in the climate section to ON and MAX the voltage dropped to **13.75V**.

Back at my desk i supplied the radio with the MAX value of 14.4V and the MIN value of 11.28V to measure the whole supply board of the HU down at the board connectors that goes down in the "main-board". Since i thought there would be a regulated value it shows off that the main power stays almost at the same values. The radio obviously can handle these differences.

So our module drops the Voltage by ~0.7V and therefore the circuit gets a voltage in between 10.65V and 13.75V and the DC/DC on the BT module board get it down to in between 3.02V (IGN at POS 1 while engine off and fan on MAX wich is not really a realistic usecase) and 4.04V. So after all this should be fine since the CS8645 can be supplied by a battery of 3.3V-4.2V.

Putting another N4004 in series before the BT module would drop the supply too much i guess. So the question still is: what blew the BT module off (remember the DC/DC ist still working, it's only the CSR8645 assembling on that board).

archi, 2019-09-18:
Hm, that's difficult to asses from afar ;-) I definitely killed one BT IC by plugging in my cable the wrong way around; maybe your cable is wrong? Did you check the the voltage levels with your cable plugged into the HU (but NOT into the PCB)?

Other than that,... no idea. I designed the board to be used with the 12V from the RUN line, which is stabilized by the HU, so even if your alternator pushes the car's voltage to 14.4V, the PCB only gets 12V (and with the single diode the resulting 11.3V are already a little bit on the low end - e.g. for me the BT sometimes didn't properly restart waiting too long in ON/POS1 before starting the ignition; past tense because the S60 is now gathering rust [still need to sell it] and the "new" V60 D6 has BT built-in).

2bitmarv, 2019-09-19:
Got it! So my BT module blew off by not using the RUN line. I measured the RUN line and in my case it's not really stabilized (in my understanding this means a stabilized source is stepping down or up depending on its input to hold a wanted value). In my V70II the RUN line itself drops the 14.4V (engine running!) by 1V and the N4004 on the board drops it another 0.7V so that the BT modules DC/DC converter drops it to the nearly perfect 3.3V. This clearly explains why the BT module doesn't work when the engine is not running because the supplied voltage is too low at the end for the BT module. I can confirm that you have to go quickly from POS1 to IGN otherwise the BT module won't start correctly. Assumed every RUN line in Volvo behave like that, a solution would be indeed to connect the VCC of the BT module directly to the RUN line before the N4004 but this also means if the engine is running the BT module gets a peak of 4.1V wich is damn near to the max. of 4.2V the module can digest.

2bitmarv, 2019-09-21:
It's pretty annoying...the Voltages are playing merry-go-round. The BT module mostly shows in my display a nearly empty supply (assuming a battery with a voltage between 3.3V and 4.2V i guess) and therefore reminds me with an alert sound from time to time. Id did not expect the circuit of a car to be so unstable like that.

Thread 15 (2017-11-12):

Old Files

mikehamm, 2017-11-12:
Hi, this is a fantastic project and it's amazing the work you've done! Apologies for asking this so soon after you've updated the code but would it be possible to get a copy of the old files?
I'm working on a halfway house between your Bluetooth system and the original 3.5mm audio only system that'll let me change tracks using a 3 ring rca connector and was hoping to borrow some of the code you used to control your footwell lights! Thanks!

mikehamm, 2017-11-12:
Realised after more digging about the code is incorporated into the new files!

visualapproach, 2017-11-12:
Hi and thank you! Of course I’ll put them back. I’m happy that someone is interested. I just need some sleep first. (The footwell lights code is still there in the new code but I understand that you wanna continue where you were)

mikehamm, 2017-11-12:
Wonderful thank you so much! Yeah sorry I had some of the files downloaded but for some reason didn't fully clone the repo. Don't rush though. Thanks for all the work you've done on this too!

Closed 2017-11-12.

Thread 17 (2018-09-03):

Power on BT module only if HU in CD-changer mode

BK-Poland, 2018-09-03:
Great job! Thank you! I have only one "little" dream: Is it possible to switch power on the BT module only when I switch to the CD changer in HU? BT turned off when I listen to FM radio.

archi, 2018-09-03:
On the hardware side you could add a relay or a suitable NPN transistor to control the power of the module. Software-wise: The protocol allows for this for sure, but @visualapproach would need to add some code to handle that (I didn't look at the code, so no idea how possible that is).

BK-Poland, 2018-09-03:
Hardware for me is no problem. The Arduino output controls the transistor that powers the BT module. The question is: it can be programmed?  @visualapproach ? Does Arduino get a message from HU that the CD-changer is on?

visualapproach, 2018-09-03:
Sure thing, I Will have a look at it and post somerhing soon.

BK-Poland, 2018-09-03:
I will be waiting for a good news. :-)

visualapproach, 2018-09-03:
check lines 43 and 713-740
That should do it, I think

BK-Poland, 2018-09-04:
I have connected according to: older_stuff/schematics_melbus_hack_v2.
All I need to do is change the PLAY PIN from 12 to 10?
And connect Arduino PIN 5 to base of NPN transistor?

visualapproach, 2018-09-04:
No, you shouldn't have to change PLAY PIN. What you wanna do is to capture POWERON-message and switch on the transistor. If POWEROFF is received, you turn off the transistor. That's all you need to change.

If you use the old code (v7i line 255 onwards), look at the following snippets and adjust according to my suggestion:

             //6, power up. resp ack (0x00), not verified
              case 6:
                byteToSend = 0x00;
                SendByteToMelbus();
                trackInfo[1] = startByte;
                trackInfo[8] = startByte;
-->   digitalWrite(5, HIGH); //change "5" to whatever pin you have connected to the transistor.
                break;
              //7, power down. ack (0x00), not verified
              case 7:
                byteToSend = 0x00;
                SendByteToMelbus();
                trackInfo[1] = stopByte;
                trackInfo[8] = stopByte;
-->   digitalWrite(5, LOW); //change "5" to whatever pin you have connected to the transistor
                break;

If you are using the newest code, do the same, but at lines 713 onwards:

            //CDC_PUP
              case 27:
                byteToSend = 0x00;
                SendByteToMelbus();
                trackInfo[1] = startByte;
                trackInfo[8] = startByte;
-->   digitalWrite(5, HIGH); //change "5" to whatever pin you have connected to the transistor.
                break;

              //CDC_PDN
              case 28:
                byteToSend = 0x00;
                SendByteToMelbus();
                trackInfo[1] = stopByte;
                trackInfo[8] = stopByte;
-->   digitalWrite(5, LOW); //change "5" to whatever pin you have connected to the transistor
                break;

Ofc remove the arrows. They are just for your attention.

visualapproach, 2018-09-05:
Yes. Wish you luck, and let us know if it works.

archi, 2018-09-07:
@visualapproach Maybe you can patch this in the repo; I think the feature doesn't do any harm if it goes unused.

BK-Poland, 2018-09-07:
Wait. First, I'll do the tests. Then I will draw a connection diagram. OK? :-)

visualapproach, 2018-09-07:
Yeah sure. If it works for BK-Poland I'll update the repo

visualapproach, 2018-09-07:
And thanks all for keeping this project alive!

BK-Poland, 2018-09-12:
The first test (older stuff code) was quite good. There is only one problem. Output D5 is in a high state also when I listen to the internal CD (HU).
When I switch to FM, BT turns off. Perfect!
When I turn on the CD-Changer, BT turns on. Perfect!
But when I turn on the Internal-HU-CD, BT also turns on. It looks like Internal-HU-CD = CD-Changer.

visualapproach, 2018-09-12:
Ok I’ll have a look at it.

visualapproach, 2018-09-12:
@BK-Poland I couldn't find anything obvious. What happens when you go from CDC->FM->CD ? Does the D5 go high->low->high?

BK-Poland, 2018-09-12:
> What happens when you go from CDC->FM->CD ? Does the D5 go high->low->high?

Yes, exactly.

BK-Poland, 2018-09-12:
There is one more interesting thing. When I switch CDC-> CD, the BT module will restart. So Arduino turns off D5 at 100ms or maybe max 200ms. You can see how the LED in the BT module goes out for a moment.

visualapproach, 2018-09-12:
Can you hook up a computr via USB and log serial output?

visualapproach, 2018-09-12:
(Don’t forget to uncomment the transmission logging in Main loop)

BK-Poland, 2018-09-12:
> Can you hook up a computr via USB and log serial output?

Sure. But... How can I do this? :-)

visualapproach, 2018-09-12:
Arduino in car, hooked up to computer via USB. Use arduino IDE to Reprogram arduino with new software (uncomment the logging part by removing the double slashes). Then turn on radio and watch the serial monitor in IDE. Switch between sources and then copy text

BK-Poland, 2018-09-12:
OK. I need 30 minutes. I'll be back... :-D

BK-Poland, 2018-09-12:
I do not know what I'm doing wrong, but the serial monitor does not work. Communication is correct, but nothing is there. Empty serial monitor window.

visualapproach, 2018-09-12:
Need to sleep now. I get back to you. Check correct port and baudrate 115Kbps (i think)

BK-Poland, 2018-09-13:
> Check correct port and baudrate 115Kbps (i think)

They are correct. I need to learn Arduino IDE :-)

visualapproach, 2018-09-13:
There is no stupid questions. I think this part should be enough:

  //Incoming serial data is supposed to look like this:
  //index, databyte: "3, 5"
  //No error checking here since we're just hacking
//  if (Serial.available() > 0) {
//    int index = Serial.parseInt();
//    trackInfo[index] = (byte) Serial.parseInt();
//    Serial.readStringUntil('\n');
//    for (byte b = 0; b < 9; b++) {
//      Serial.print(trackInfo[b], HEX);
//      Serial.print("-");
//    }
//    Serial.println();
//  }

-->

  //Incoming serial data is supposed to look like this:
  //index, databyte: "3, 5"
  //No error checking here since we're just hacking
 if (Serial.available() > 0) {
    int index = Serial.parseInt();
    trackInfo[index] = (byte) Serial.parseInt();
    Serial.readStringUntil('\n');
    for (byte b = 0; b < 9; b++) {
      Serial.print(trackInfo[b], HEX);
      Serial.print("-");
   }
   Serial.println();
}

visualapproach, 2018-09-13:
@BK-Poland
Good, you got serial monitoring to work!

Here is a "translation" of the log:

`
(connect to Arduino, HU is on FM)
7 1A EE F8 7F
E8 1E EF (Cartridge info request)

E9 1B E0 1 8 track info request)
(FM to CDC) -> E8 19 2F (****CDC Power UP****)
E9 1B E0 1 8 track info request)

E9 1B E0 1 8 track info request)

E9 1B E0 1 8 track info request)

E9 1B E0 1 8 track info request)

E9 1B E0 1 8 track info request)

E9 1B E0 1 8 track info request)

E9 1B E0 1 8 track info request)

E9 1B E0 1 8 track info request)

E9 1B E0 1 8 track info request)

E9 1B E0 1 8 track info request)

E9 1B E0 1 8 track info request)

E9 1B E0 1 8 track info request)

E9 1B E0 1 8 track info request)

E9 1B E0 1 8 track info request)

E9 1B E0 1 8 track info request)
E8 19 22 (**CDC Power DOWN**)
81 1B E0 1 8 10 2 1 1 80 1 C CC CC
E9 1B E0 1 8 track info request)
80 19 2F 0 E 76 43 C3 FC C0 70 A4 0 80 C0 0 87 FF FF
(CDC to CD) -> 81 1B E0 1 8 10 48 1 1 80 1 F FF FF

81 1B E0 1 8 10 48 1 1 80 1 F FF FF

81 1B E0 1 8 10 48 1 1 80 1 F FF FF

81 1B E0 1 8 10 48 1 1 80 1 F FF FF

81 1B E0 1 8 10 48 1 1 80 1 F FF FF

81 1B E0 1 8 10 48 1 1 80 1 F FF FF
0 1C EC

81 1B E0 1 8 10 8 1 1 80 1 0 5 32
0 1C EC
81 1B E0 1 8 10 8 1 1 80 1 0 5 33

81 1B E0 1 8 10 8 1 1 80 1 0 5 33
0 1C EC
81 1B E0 1 8 10 8 1 1 80 1 0 5 34

81 1B E0 1 8 10 8 1 1 80 1 0 5 34
0 1C EC
81 1B E0 1 8 10 8 1 1 80 1 0 5 35

81 1B E0 1 8 10 8 1 1 80 1 0 5 35
0 1C EC
81 1B E0 1 8 10 8 1 1 80 1 0 5 36

81 1B E0 1 8 10 8 1 1 80 1 0 5 36
0 1C EC
81 1B E0 1 8 10 8 1 1 80 1 0 5 37
80 19 22 0 E 76 43 C3 FC C0 70 A1 0 80 C0 0 86 66 66
21:10:46.682 -> E9 1B E0 1 8 track info request)
81 1B E0 1 8 10 42 1 1 80 1 C CC CC
E8 19 2F (****CDC Power UP****)
(CD to CDC) -> E9 1B E0 1 8 track info request)
0 1C EC
E9 1B E0 1 8 track info request)

E9 1B E0 1 8 track info request)

E9 1B E0 1 8 track info request)

E9 1B E0 1 8 track info request)

E9 1B E0 1 8 track info request)

E9 1B E0 1 8 track info request)

E9 1B E0 1 8 track info request)

E9 1B E0 1 8 track info request)

E9 1B E0 1 8 track info request)

E9 1B E0 1 8 track info request)

E9 1B E0 1 8 track info request)

E9 1B E0 1 8 track info request)

E9 1B E0 1 8 track info request)

E9 1B E0 1 8 track info request)

E9 1B E0 1 8 track info request)

E9 1B E0 1 8 track info request)

E9 1B E0 1 8 track info request)

E9 1B E0 1 8 track info request)

E9 1B E0 1 8 track info request)
E8 19 22 (**CDC Power DOWN**)
(CDC to FM) -> E9 1B E0 1 8 track info request)

80 19 22 0 E 76 43 C3 FC C0 70 81 0 C0 C0 0 86 66 66
(Shut down HU) -> E8 19 22 (**CDC Power DOWN**)
81 1B E0 1 8 10 2 1 81 80 1 C CC CC
21:11:04.113 -> E9 1B E0 1 8 track info request)

0 18 12
`

It appears the communication is good and the HU does the right thing. That narrows it down to program error or hardware error.
Please add following lines to your code and reupload, then check serial output again.

after case 6, directly after the line "digitalWrite(5, HIGH);" add this

Serial.println("***D5 ON***");

after case 7, directly after the line "digitalWrite(5, LOW);" add this

Serial.println("***D5 OFF***");

visualapproach, 2018-09-13:
You are also welcome to post that part of your code if you want me to check for errors.

BK-Poland, 2018-09-14:
7 1A EE F8 7F
E8 1E EF
E9 1B E0 1 8
D5 ON
E8 19 2F
E9 1B E0 1 8
E9 1B E0 1 8
E9 1B E0 1 8
E9 1B E0 1 8
E9 1B E0 1 8
E9 1B E0 1 8
E9 1B E0 1 8
E9 1B E0 1 8
E9 1B E0 1 8
D5 OFF
E8 19 22
81 1B E0 1 8 10 2 1 1 80 1 C CC CC
E9 1B E0 1 8
D5 ON
80 19 2F 0 E 76 43 C3 FC C0 70 A4 0 80 C0 0 80 2 A0
81 1B E0 1 8 10 48 1 1 80 1 0 5 40
81 1B E0 1 8 10 48 1 1 80 1 0 5 40
81 1B E0 1 8 10 48 1 1 80 1 0 5 40
81 1B E0 1 8 10 48 1 1 80 1 0 5 40
81 1B E0 1 8 10 48 1 1 80 1 0 5 40
81 1B E0 1 8 10 8 1 1 80 1 0 5 40
0 1C EC
81 1B E0 1 8 10 8 1 1 80 1 0 5 40
0 1C EC
81 1B E0 1 8 10 8 1 1 80 1 0 5 41
D5 OFF
80 19 22 0 E 76 43 C3 FC C0 70 A1 0 80 C0 0 86 66 66
E9 1B E0 1 8
81 1B E0 1 8 10 42 1 1 80 1 C CC CC
D5 ON
E8 19 2F
E9 1B E0 1 8
0 1C EC
E9 1B E0 1 8
E9 1B E0 1 8
E9 1B E0 1 8
E9 1B E0 1 8
E9 1B E0 1 8
D5 OFF
E8 19 22
E9 1B E0 1 8
D5 OFF
80 19 22 0 C 91 0
81 1B E0 1 8 10 2 1 1 80 1 C CC CC
E9 1B E0 1 8

visualapproach, 2018-09-14:
yeah it's code related. I'll investigate. Could you send me your code by email?

BK-Poland, 2018-09-14:
/*
  new:
  Press cd1 or cd2 to change bluetooth volume.
  Cd change is resetting track number.

  By Thomas Landahl, 2017-04-25

*/

#define MELBUS_CLOCKBIT (byte)2 //Pin D2  - CLK
#define MELBUS_DATA (byte)3     //Pin D3  - Data
#define MELBUS_BUSY (byte)4     //Pin D4  - Busy
const byte prevPin = 8;
const byte nextPin = 9;
const byte upPin = 10;    //volume up
const byte downPin = 11;  //volume down
const byte playPin = 12;

//volatile variables used inside and outside of ISP
volatile byte melbus_ReceivedByte = 0;
volatile byte melbus_Bitposition = 7;
volatile bool byteIsRead = false;

byte byteToSend = 0;  //global to avoid unnecessary overhead
unsigned long Connected = 0;

//preset parameters
byte track = 0x01; //Display show HEX value, not DEC. (A-F not "allowed")
byte cd = 0x01; //1-10 is allowed (in HEX. 0A-0F and 1A-1F is not allowed)
byte powerup_ack = 0x00;

//Base adresses.
//const byte MD_ADDR = 0x70;  //internal
//const byte CD_ADDR = 0x80;  //internal
//const byte TV_ADDR = 0xA8;  //might be A9 during main init sequence
//const byte DAB_ADDR = 0xB8;
//const byte SAT_ADDR = 0xC0;
//const byte MDC_ADDR = 0xD8;
//const byte CDC_ADDR = 0xE8;
//const byte RESPONSE = 0x06; //add this to base adress when responding to HU
//const byte MASTER = 0x07;   //add this to base adress when requesting/beeing master

//change theese definitions if you wanna emulate another device.
//My HU-650 don't accept anything but a CD-C (so far).
#define RESPONSE_ID 0xEE  //ID while responding to init requests (which will use base_id)
#define MASTER_ID 0xEF    //ID while requesting/beeing master
#define BASE_ID 0xE8      //ID when getting commands from HU
#define ALT_ID 0xE9       //Alternative ID when getting commands from HU

//This list can't be too long. We only have so much time between the received bytes. (approx 500 us)
const byte commands[][5] = {
  {BASE_ID, 0x1E, 0xEF},             //0, Cartridge info request. Respond with 6 bytes (confirmed)
  {ALT_ID, 0x1B, 0xE0, 0x01, 0x08},  //1, track info req. resp 9 bytes
  {BASE_ID, 0x1B, 0x2D, 0x40, 0x01}, //2, next track.
  {BASE_ID, 0x1B, 0x2D, 0x00, 0x01}, //3, prev track
  {BASE_ID, 0x1A, 0x50},             //4, change cd
  {BASE_ID, 0x1A, 0x50},             //5, not used
  {BASE_ID, 0x19, 0x2F},             //6, power up. resp ack (0x00), 0x19 could be 0x49??
  {BASE_ID, 0x19, 0x22},             //7, power down. ack (0x00), not verified
  {BASE_ID, 0x19, 0x29},             //8, FFW. ack, not verified
  {BASE_ID, 0x19, 0x26},             //9, FRW. ack, not verified
  {BASE_ID, 0x19, 0x2E},             //10 scan mode. ack, cmd verified!
  {BASE_ID, 0x19, 0x52},             //11 random mode. ack, not verified
  {0x07, 0x1A, 0xEE},                //12 main init seq. wait for BASE_ID and respond with RESPONSE_ID.
  {0x00, 0x00, 0x1C, 0xED},          //13 secondary init req. wait for BASE_ID and respond with RESPONSE_ID.
  {0x00, 0x1C, 0xEC}                 //14 master req broadcast. wait for MASTER_ID and respond with MASTER_ID.
};
//keep track of the length of each command. (The two dimensional array above have fixed width (padded with 0x00))
const byte listLen = 15;
byte cmdLen[listLen] = {3, 5, 5, 5, 3, 3, 3, 3, 3, 3, 3, 3, 3, 4, 3};

//arrays to send to HU when requested

//TRACK INFO
/*According to internet resources, HEX 10 88 01 01 80 03 00 02 22 should be a valid answer.
  another source: 0x00, 0x02, 0x00, 0x01, 0x80, 0x01, 0xff, 0x60, 0x60
  All comments in HEX

  0.  10, 14, 20, 24, 30, 34, 80, 84, 90, 94 => HU is OK, else error
  1.  Status message
    01 = able to select cd by pushing HU-buttons but it resets to 01 after a couple of secs
    00, 10, 20, 40 = HU display: cd load cartridge (decimal numbers here??)
    22 = HU asking for status rapidly
    11 = HU display: CD cartridge empty
    44 = HU display: CD number is blinking
    81 = HU display: cd error

  2.  8 = HU display: random
  3.  HU display: CD number (1-10). 0x10 shows "CD  ". 0x0A (DEC 10) does not work?
        HU displays each nibble, and only values < A is valid.
  4.  Unknown meaning.
  5.  TRACK number
  6.  Hours     not displayed on HU-650
  7.  Minutes   not displayed on HU-650
  8.  Status Power?

*/
byte trackInfo[] = {0x00, 0x02, 0x00, cd, 0x80, track, 0xC7, 0x0A, 0x02}; //9 bytes
byte startByte = 0x08; //on powerup - change trackInfo[1] & [8] to this
byte stopByte = 0x02; //same on powerdown

//CARTRIDGE INFO
//According to internet resources, HEX 00 08 01 4A 0C CC is a valid answer.
//another source: 0x00, 0x0f, 0xff, 0x4a, 0xfc, 0xff
byte cartridgeInfo[] = {0x00, 0xFC, 0xFF, 0x4A, 0xFC, 0xFF};              //6 bytes
// 0xFC = B1111 1100; first six bits for each CD in 6-CD cartridge??

//MASTER MODE INFO
byte masterInfo[] = {0xF8, 0x85, 0xE2, 0x80, 0x03, 0x00, 0x02, 0x02};     //8 bytes

void setup() {
  //Disable timer0 interrupt. It's is only bogging down the system. We need speed!
  TIMSK0 &= ~_BV(TOIE0);

  //All lines are idle HIGH
  pinMode(MELBUS_DATA, INPUT_PULLUP);
  pinMode(MELBUS_CLOCKBIT, INPUT_PULLUP);
  pinMode(MELBUS_BUSY, INPUT_PULLUP);
  pinMode(nextPin, OUTPUT);
  pinMode(prevPin, OUTPUT);
  pinMode(playPin, OUTPUT);
  pinMode (5, OUTPUT);
  digitalWrite (5, LOW);
  digitalWrite(nextPin, LOW);
  digitalWrite(prevPin, LOW);
  digitalWrite(playPin, LOW);

  //LED indicates connected status.
  pinMode(13, OUTPUT);
  digitalWrite(13, LOW);

  //Activate interrupt on clock pin
  attachInterrupt(digitalPinToInterrupt(MELBUS_CLOCKBIT), MELBUS_CLOCK_INTERRUPT, RISING);

  //Initiate serial communication to debug via serial-usb (arduino)
  //For debugging purpose. Better off without it when things work.
  //Serial printing take a lot of time!!
  Serial.begin(115200);

  //Call function that tells HU that we want to register a new device
  melbusInitReq();
}

//Main loop
void loop() {
  static byte byteCounter = 0;  //keep track of how many bytes is sent in current command
  static byte lastByte = 0;     //used to copy volatile byte to register variable. See below
  static byte matching[listLen];     //Keep track of every matching byte in the commands array
  //static byte msgCount = 0;          //inc every time busy line goes idle.
  //static byte masterCount = 0;
  byte melbus_log[99];  //main init sequence is 61 bytes long...
  bool flag = false;
  bool BUSY = PIND & (1 << MELBUS_BUSY);

  Connected++;
  //check BUSY line active (active low)
  while (!BUSY) {
    //Transmission handling here...
    //debug
    //PORTB |= 1 << 5;
    if (byteIsRead) {
      //debug
      //PORTB &= ~(1 << 5);
      byteIsRead = false;
      lastByte = melbus_ReceivedByte; //copy volatile byte to register variable
      //Well, since HU is talking to us we might call it a conversation.
      Connected = 0;
      melbus_log[byteCounter] = lastByte;
      //Loop though every command in the array and check for matches. (No, don't go looking for matches now)
      for (byte cmd = 0; cmd < listLen; cmd++) {
        //check if this byte is matching
        if (lastByte == commands[cmd][byteCounter]) {
          matching[cmd]++;
          //check if a complete command is received, and take appropriate action
          if (matching[cmd] == cmdLen[cmd]) {
            switch (cmd) {
              //0, Cartridge info request. Respond with 6 bytes
              case 0:
                SendCartridgeInfo();
                break;
              //1, track info req. resp 9 bytes
              case 1:
                SendTrackInfo();
                //Serial.println("  trk info sent");
                break;
              //2, next track.
              case 2:
                track++;
                fixTrack();
                trackInfo[5] = track;
                nextTrack();
                break;
              //3, prev track
              case 3:
                track--;
                fixTrack();
                trackInfo[5] = track;
                prevTrack();
                break;
              //4, change cd
              case 4:
                //wait for next byte to get CD number
                while (!(PIND & (1 << MELBUS_BUSY))) {
                  if (byteIsRead) {
                    byteIsRead = false;
                    switch (melbus_ReceivedByte) {
                      case 0x81:
                        cd = 1;
                        volumeDown(); //internal to BT-module, not BT source
                        track = 1;
                        break;
                      case 0x82:
                        cd = 2;
                        volumeUp(); //internal to BT-module, not BT source
                        track = 1;
                        break;
                      case 0x83:
                        cd = 3;
                        track = 1;
                        break;
                      case 0x84:
                        cd = 4;
                        track = 1;
                        break;
                      case 0x85:
                        cd = 5;
                        track = 1;
                        break;
                      case 0x86:
                        cd = 6;
                        track = 1;
                        break;
                      case 0x41:
                        cd++;
                        track = 1;
                        break;
                      case 0x01:
                        cd--;
                        track = 1;
                        break;
                      default:
                        track = 1;
                        break;
                    }
                  }
                }
                trackInfo[3] = cd;
                trackInfo[5] = track;
                break;
              //5, not used
              case 5:
                break;
              //6, power up. resp ack (0x00), not verified
              case 6:
                byteToSend = 0x00;
                SendByteToMelbus();
                trackInfo[1] = startByte;
                trackInfo[8] = startByte;
                digitalWrite(5, HIGH);
                Serial.println("D5 ON");
                break;
              //7, power down. ack (0x00), not verified
              case 7:
                byteToSend = 0x00;
                SendByteToMelbus();
                trackInfo[1] = stopByte;
                trackInfo[8] = stopByte;
                digitalWrite(5, LOW);
                Serial.println("D5 OFF");
                break;
              //8, FFW. ack, not verified
              case 8:
                byteToSend = 0x00;
                SendByteToMelbus();
                break;
              //9, FRW. ack, not verified
              case 9:
                byteToSend = 0x00;
                SendByteToMelbus();
                break;
              //10 scan mode.
              //Used as a PLAY button here
              case 10:
                byteToSend = 0x00;
                SendByteToMelbus();
                play();
                //trackInfo[0]++; //debug
                break;
              //11 random mode.
              //Used as a PLAY button here
              case 11:
                byteToSend = 0x00;
                SendByteToMelbus();
                play();
                break;
              //12 main init seq. wait for BASE_ID and respond with RESPONSE_ID.
              case 12:
                //wait for base_id and respond with response_id
                while (!(PIND & (1 << MELBUS_BUSY))) {
                  if (byteIsRead) {
                    byteIsRead = false;
                    //debug get whole message
                    //byteCounter++;
                    //melbus_log[byteCounter] = melbus_ReceivedByte;
                    //end debug
                    if (melbus_ReceivedByte == BASE_ID) {
                      byteToSend = RESPONSE_ID;
                      SendByteToMelbus();
                      break;
                    }
                  }
                }
                break;
              //13 secondary init req. wait for BASE_ID and respond with RESPONSE_ID.
              case 13:
                //wait for base_id and respond response_id
                //digitalWrite(13, HIGH);
                while (!(PIND & (1 << MELBUS_BUSY))) {
                  if (byteIsRead) {
                    byteIsRead = false;
                    //debug get whole message
                    //byteCounter++;
                    //melbus_log[byteCounter] = melbus_ReceivedByte;
                    //end debug
                    if (melbus_ReceivedByte == BASE_ID) {
                      byteToSend = RESPONSE_ID;
                      SendByteToMelbus();
                      break;
                    }
                  }
                }
                break;
              //14 master req broadcast. wait for MASTER_ID and respond with MASTER_ID. (not used in this sketch)
              case 14:
                while (!(PIND & (1 << MELBUS_BUSY))) {
                  if (byteIsRead) {
                    byteIsRead = false;
                    if (melbus_ReceivedByte == MASTER_ID) {
                      byteToSend = MASTER_ID;
                      SendByteToMelbus();
                      //do stuff here to send message to HU, like
                      masterSend();
                      break;
                    }
                  }
                }
                break;
                //              //15
                //              case 15:
                //                byteToSend = 0x00;
                //                SendByteToMelbus();
                //                break;
                //              //16
                //              case 16:
                //                byteToSend = 0x00;
                //                SendByteToMelbus();
                //                break;
                //              //17
                //              case 17:
                //                byteToSend = 0x00;
                //                SendByteToMelbus();
                //                break;
            }
            break;    //bail for loop. (Not meaningful to search more commands if one is already found)
          } //end if command found
        } //end if lastbyte matches
      }  //end for cmd loop
      byteCounter++;
    }  //end if byteisread
    //Update status of BUSY line, so we don't end up in an infinite while-loop.
    BUSY = PIND & (1 << MELBUS_BUSY);
    if (BUSY) {
      flag = true; //used to execute some code only once between transmissions
    }
  }

  //Do other stuff here if you want. MELBUS lines are free now. BUSY = IDLE (HIGH)
  //Don't take too much time though, since BUSY might go active anytime, and then we'd better be ready to receive.
  //Printing transmission log (incoming, before responses)
  if (flag) {
  for (byte b = 0; b < byteCounter; b++) {
  Serial.print(melbus_log[b], HEX);
  Serial.print(" ");
  }
  Serial.println();
  }

  //Reset stuff
  byteCounter = 0;
  melbus_Bitposition = 7;
  for (byte i = 0; i < listLen; i++) {
    matching[i] = 0;
  }
  if (Connected > 2000000) {
    melbusInitReq();
    Connected = 0;
  }

  //Incoming serial data is supposed to look like this:
  //index, databyte: "3, 5"
  //No error checking here since we're just hacking
//  if (Serial.available() > 0) {
//    int index = Serial.parseInt();
//    trackInfo[index] = (byte) Serial.parseInt();
//    Serial.readStringUntil('\n');
//    for (byte b = 0; b < 9; b++) {
//      Serial.print(trackInfo[b], HEX);
//      Serial.print("-");
//    }
//    Serial.println();
//  }

  // I haven't seen any advantages from sending messages to HU.
  //Therefore this section is disabled.
  //  if (flag) {
  //    if(some timed interval etc)
  //    reqMaster();
  //  }

  flag = false; //don't print during next loop. Wait for new message to arrive first.
}

//Notify HU that we want to trigger the first initiate procedure to add a new device (CD-CHGR) by pulling BUSY line low for 1s
void melbusInitReq() {
  //Serial.println("conn");
  //Disable interrupt on INT0 quicker than: detachInterrupt(MELBUS_CLOCKBIT_INT);
  EIMSK &= ~(1 << INT0);

  // Wait until Busy-line goes high (not busy) before we pull BUSY low to request init
  while (digitalRead(MELBUS_BUSY) == LOW) {}
  delayMicroseconds(20);

  pinMode(MELBUS_BUSY, OUTPUT);
  digitalWrite(MELBUS_BUSY, LOW);
  //timer0 is off so we have to do a trick here
  for (unsigned int i = 0; i < 12000; i++) delayMicroseconds(100);

  digitalWrite(MELBUS_BUSY, HIGH);
  pinMode(MELBUS_BUSY, INPUT_PULLUP);
  //Enable interrupt on INT0, quicker than: attachInterrupt(MELBUS_CLOCKBIT_INT, MELBUS_CLOCK_INTERRUPT, RISING);
  EIMSK |= (1 << INT0);
}

//This is a function that sends a byte to the HU - (not using interrupts)
//SET byteToSend variable before calling this!!
void SendByteToMelbus() {
  //Disable interrupt on INT0 quicker than: detachInterrupt(MELBUS_CLOCKBIT_INT);
  EIMSK &= ~(1 << INT0);

  //Convert datapin to output
  //pinMode(MELBUS_DATA, OUTPUT); //To slow, use DDRD instead:
  DDRD |= (1 << MELBUS_DATA);

  //For each bit in the byte
  for (int i = 7; i >= 0; i--)
  {
    while (PIND & (1 << MELBUS_CLOCKBIT)) {} //wait for low clock
    //If bit [i] is "1" - make datapin high
    if (byteToSend & (1 << i)) {
      PORTD |= (1 << MELBUS_DATA);
    }
    //if bit [i] is "0" - make datapin low
    else {
      PORTD &= ~(1 << MELBUS_DATA);
    }
    while (!(PIND & (1 << MELBUS_CLOCKBIT))) {}  //wait for high clock
  }

  //Reset datapin to high and return it to an input
  //pinMode(MELBUS_DATA, INPUT_PULLUP);
  PORTD |= 1 << MELBUS_DATA;
  DDRD &= ~(1 << MELBUS_DATA);

  //Enable interrupt on INT0, quicker than: attachInterrupt(MELBUS_CLOCKBIT_INT, MELBUS_CLOCK_INTERRUPT, RISING);
  EIMSK |= (1 << INT0);
}

//Global external interrupt that triggers when clock pin goes high after it has been low for a short time => time to read datapin
void MELBUS_CLOCK_INTERRUPT() {
  //Read status of Datapin and set status of current bit in recv_byte
  //if (digitalRead(MELBUS_DATA) == HIGH) {
  if ((PIND & (1 << MELBUS_DATA))) {
    melbus_ReceivedByte |= (1 << melbus_Bitposition); //set bit nr [melbus_Bitposition] to "1"
  }
  else {
    melbus_ReceivedByte &= ~(1 << melbus_Bitposition); //set bit nr [melbus_Bitposition] to "0"
  }

  //if all the bits in the byte are read:
  if
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

Thread 18 (2018-09-12):

Showing temperature from two DS18B20 on HU display in SAT mode

BK-Poland, 2018-09-12:
Is it possible? :-)
Example: Temp1: 20 C, Temp2: 10 C
Of course, the play / next / prev functions still work.

visualapproach, 2018-09-12:
Yes it is possible. There are four textlines. Switch between them by pressing RND on HU. Or you can put both temps on a single line if you stay within the display limit (14 chars?) Ofc you need to adapt the code. Look at how I show the battery voltage. Ask if you need specific help.

Closed 2018-09-14.

Thread 19 (2018-10-01):

Ticking noise

RSchalkwijk, 2018-10-01:
Hi thanks for the good documentation / schematics / descriptions.
I've implemented the project with some success however the constant ticking gremlin is really keeping me from claiming this project successful.
My first thought was that it was a grounding issue however I've tried every conceivable combination of power and grounding options with no success.
I believe there could be an issue with the code as the ticking is dependent on the skip button as well.
On my project the ticking is constant for about 50 seconds then briefly goes away.
I've hooked up a logic analyzer to the data,busy and clock lines while connected to the radio.
Could I send this to you to have a look at and confirm my suspicion that the issue is code related?

visualapproach, 2018-10-01:
Hi @RSchalkwijk! Welcome and thanks!
Assumption: you are using the code in this repository.
The code is responsible for sending data over Melbus lines. That in turn makes electronical noise which is picked up by the audio lines. So the only way to make silence BY CODE is to stop sending data, which contradicts the purpose of the device. Solution is in the hardware.
What bluetooth module do you have?
Are you using a Ground Loop Isolator?
I can recommend the CSR8645 BT module. I think @archi is using it without a GLI. The old DIY module is notoriously difficult to get noise free and definately needs one.

RSchalkwijk, 2018-10-01:
I've tried a ground loop isolator which did not help. At the moment I have no audio lines connected to the audio R,L,Common. I tried to simplify everything in order to isolate possible noise. I used an original volvo din cable that plugs into the radio and a female socket - the socket connects to my proto-board.
I've used heat shrink and insulation to ensure that there is no connection form the melbus to the audio lines. The weird thing is that the noise disappears every 50ish seconds for about 4 seconds...

If messed around a bit a noticed that if  you disconnect the device from the radio for some reason it sometimes still registers the CD-C... The ticking sound is then more regular with no break in the repeating pattern - so where does that noise come from?  Was thinking its a possible noise that comes if the request for reply from the HU is NAC'd?

RSchalkwijk, 2018-10-01:
I can mail you the logs and traces from the logic analyzer? My coding skills are very limited, would be great if you can verify what the ticking is -  I suspect others have  possibly picked up the same issue. The ticking sound feels like some sort of barbaric torture to me. Was thinking of buying an aftermarket product (Yatour,grom...) but not sure if it will fix the issue if its something to do with my HU. Thanx again!

visualapproach, 2018-10-01:
Yes the HU is keeping the input open but will eventually show [source] error. Even if you unplug the cable, the HU keeps sending data on Melbus lines while talking to the internal CD player. Thats most likely what's get picked up by the audio lines, internal to the HU. So while plugging the arduino in might make the noise louder, since the cables might act as an antenna, it is no longer the source of the "data noise". I also had the ticking problem, but changing BT-module to CSR solved that. Me and others are using the same code without problem, so it is not code related (IMHO ;), so analyzing the data is not meaningful i think. But if it makes you feel better, sure. Send it and I'll check when I got some spare time.

RSchalkwijk, 2018-10-01:
Cool thanx, I'll try that BT module first. One question does the CSR you use have a "pre-amp"? The ticking noise is only really audible from say 25% HU volume but that is way too soft if the audio lines are being used for an aux cable or for the BT module I tried

archi, 2018-10-02:
Hey, remote diagnostics are difficult, but you're saying you didn't connect the audio lives to anything? My first try would be to terminate those, since they're going to pick up a lot of noise in a car. Just short L and R to audio common ground using a 4k7 resistor each and see if that helps.

Imho that's the most likely culprit. Back when I was using an aux cable instead of a BT module I had a lot of noise while the cable was unplugged and the radio set to CD-Changer/Aux.

archi, 2018-10-02:
Also, yes, the module has a pre-amp. They claim to use a specialized TI headphones preamp (dual op amp plus some other features; much better than general purpose parts). The part is quite small, so I couldn't check the markings, but I believe they've actually used it.

Bonus: The module even has an isolated audio ground, which is why *that* module doesn't need a ground loop breaker :)

BK-Poland, 2018-10-04:
I have the same problem. 560 ohm resistors help but not quite. Currently, I have the audio cable and the signal cable together on the length of the meter. I plan to shorten and separate audio cable. Maybe I'll even put on a shielded audio cable. What do you think, visualapproach?

visualapproach, 2018-10-04:
I think a CSR8645 is less hassle and better result. Else a GLI is a must and i am not sure how well it Will work.

AudioDrugs, 2018-11-13:
Interesting. Im using original cd-changer cable. Actually no audio connected. Noise from data pins. Any solution?

Video:
[20181113_224247_1.zip](https://github.com/visualapproach/Volvo-melbus/files/2578046/20181113_224247_1.zip)

BK-Poland, 2018-11-14:
What is a "GLI" ? :-)

Arroquw, 2020-04-08:
> Hey, remote diagnostics are difficult, but you're saying you didn't connect the audio lines to anything? My first try would be to terminate those, since they're going to pick up a lot of noise in a car. Just short L and R to audio common ground using a 4k7 resistor each and see if that helps.
>
> Imho that's the most likely culprit. Back when I was using an aux cable instead of a BT module I had a lot of noise while the cable was unplugged and the radio set to CD-Changer/Aux.

This is what happening to me now, adding the resistors doesn't help at all though. When not even my board is connected and there is just the cable (after having it initialise as CDC) the ticking noise will still continue. GLI doesn't work either

AudioDrugs, 2024-03-02:
Hey guys.
Did some one managed how to reduce the noise?

I made a quite good 4 layer PCB with FSC-1026D (QCCC3034) and DAC and found that all these fancy things are not helping. In this video music was paused and HU volume was set to max. HU constantly sending a master and track info requests. Is it possible to prevent HU from requesting track info? The same noise remains while running module is unplugged.

https://github.com/visualapproach/Volvo-melbus/assets/29013110/b4f29dac-7d09-4941-bbc1-d48249ff6ff2

Aslo I have a BlueMusic emulator which is based on PIC16F and has 100ohm termination, but in this module data noise is ultra low. And it remains low even running module is unplugged. I guess it is possible to stop HU from sending these requests.

Thread 20 (2018-10-04):

3D print a box for archi's PCB

visualapproach, 2018-10-04:
Be patient. Design is made. I just have to test print before release.

visualapproach, 2018-10-04:
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

visualapproach, 2018-10-04:
Features: strain relief, Holes for melbus, USB and extra. Click snap lid.

visualapproach, 2018-10-05:
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

visualapproach, 2018-10-05:
[Box for BT PCB_Clicksnap github melbus box v4_box_.zip](https://github.com/visualapproach/Volvo-melbus/files/2451742/Box.for.BT.PCB_Clicksnap.github.melbus.box.v4_box_.zip)

visualapproach, 2018-10-18:
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

ULN2003A darlington IC to drive RGB LEDs. Controlled from the HU.
(I use common anode RGB LEDs and 12v. The resistor values are around 500 Ohms)

Sometime I will update the box since it is too tight to use sockets.

visualapproach, 2018-10-22:
[Clicksnap github melbus box v7.zip](https://github.com/visualapproach/Volvo-melbus/files/2503081/Clicksnap.github.melbus.box.v7.zip)

Larger case to accomodate PCB + protoboard LED driver

Thread 22 (2018-12-23):

Another MCU

AudioDrugs, 2018-12-23:
Did some one tried to migrate to ARM or STM?

I've got tons of errors. Trying to fix...

visualapproach, 2018-12-23:
The code contains some platform specific parts. Like direct port manipulation and timing etc. With a faster processor you could probably use ordinary time-functions and leave interrupts on most of the time.

Arroquw, 2023-11-06:
I have a semi-working version here:
https://github.com/Arroquw/stm32cdc/tree/stm32cubeideproject

Arroquw, 2023-12-08:
https://github.com/Arroquw/volvo_melbus_stm32

works now

Thread 23 (2019-01-27):

Why is the CD-Changer (CDC) mode used for bluetooth?

kyleloyka, 2019-01-27:
When reading through the code, I saw that the Arduino lists itself as a CD Changer. I found a document that shows different Melbus functionalities (see the "Appendix Known IDs" section at https://volvo.wot.lv/doku.php?id=melbus). I feel like "Media Device (MD)" unit is more descriptive of what the device will do. It also looks like a MD supports the same commands as a CDC. Is there a reason why MD was not chosen?

kyleloyka, 2019-01-27:
Never mind, I see that this has been discussed in #10 (https://github.com/visualapproach/Volvo-melbus/issues/10#issuecomment-337343095)

Thread 24 (2019-08-12):

Doesn't seem to work properly with HU-603

Maxima666, 2019-08-12:
So I've soldered the module as the schedule shown (I guess it's the same as for archi's PCB?) and is using the .ino meant for archi's PCB!
But the text does not come through, and I can't cycle through different texts, it just says "Track 01" and so on, or what ever it's supposed to say with an actual cd changer installed.

Plus, when i press the RND-button, it just works as a Play/Pause-button, odd?

Otherwise it works perfecly!
Unbelievable in audio quality from those cassette-to-3,5mm I've been using before!

best,
Maxima

visualapproach, 2019-08-12:
Hi Maxima, Nice! Yeah, text will only work in SAT mode (not CD Changer mode). Same for RND-button. I don’t know which HU models support SAT, but if yours doesn’t its nothing wrong with your build. If there is a SOURCE selector try to cycle through and look for SAT.

jurgislipsnis, 2019-10-28:
To convert this to work as MD changer, I only need to change BASE_ID? As I have HU803, SAT is not an option for me

visualapproach, 2019-10-28:
@jurgislipsnis It might open the md as audio source but text will not work by just changing base id.

NeoRanga, 2020-01-02:
Hi, I have an HU-603 and I use archi's PCB.
But i can't get it to work properly, when I connect it to the HU I can select the CD-Changer and i hear the BT-module power up thru the speakers and then I think it's powering down and the light on the BT-Module turns off.
If I connect 12v directly to the PCB without the HU the BT-Module stays on and I can connect to it.

visualapproach, 2020-01-02:
Hi, Sounds like a power supply issue then. I'd check voltage at the PCB in car, everything connected and running. Voltage drops may occur due to poor power/GND cord or you may have a short somewhere.
Where do you get 12V from? The DIN-connector's 12V line was weak on my HU so I had to use 12V from the cigarette lighter.
It may also be over voltage. Someone here mentioned that he had that problem IIRC.

NeoRanga, 2020-01-02:
I use the power from the DIN-connector and I will try to use power from cig-lighter instead. But when I tested it on the bench, it draws less then 100mA @ 12v. The HU-603 doesn't have a play button, can I program an alternative button, or is it already done? There isn't some shutdown command that is turning the BT-Module off? cuz the nano appears to keep running.

visualapproach, 2020-01-02:
Try that. There is no BT OFF command by default. Yes you can change the code so any button can do any of the available functions. Read through the code and it should be fairly obvious where to change the button commands. Hope it works out

NeoRanga, 2020-01-05:
Connected it directly to 12v and I could pair the phone and play some music. But after about 1min, the BT-module stopped working. CD-Changer Emu is still working, but I think the BT-module fried.

visualapproach, 2020-01-06:
@NeoRanga check this out
https://github.com/visualapproach/Volvo-melbus/issues/10#issuecomment-460001748

NeoRanga, 2020-01-09:
Thank for the link, but I think something has happened to the bt-module. There is no power light on the module and i have tried to feed it with 14v from a bench power supply, but still nothing.

2bitmarv, 2020-01-19:
@NeoRanga: I think you fried your BT module. So i did and therefore started to inspect some things: #14
So i invite you to read about it and find out that your car is NEVER serving 12V! Values rise and fall like a rollercoaster depending on how many consumers are working. If you are using the same BT module as me an Archi then things can get annoying because providing this nasty little thang has to be really delicate due to its limited range. I recommend using the RUN line from CD-Changer as it is somehow stabilized. Cig-Lighter Power is much to much. Although the Nano PCB will take it without hassle but your BT module will provided with too much power.

NeoRanga, 2020-01-19:
@2bitmarv Hi, I did use the run line at first, but the BT-module powered up and then directly down. I think the BT-module I used had a 12v regulator, but i have to check that. The module worked for a while when connected to 12v cig. No magic smoke, it just powered down forever. The car wasn't running, so the voltage was around 12,5v.

2bitmarv, 2020-01-19:
@NeoRanga : Ok, another thing might be the various quality of these "cheap" BT modules. These "little things to experiment with" mostly rely on a stabilized power supply. I fried many modules of various types or received them already dead on delivery. Good Luck!

Arroquw, 2020-02-14:
When using the RUN from the DIN instead of 12v from cig lighter, are they just interchangeable in the PCB design? So instead of external 12v line you just connect run to the transistor?

visualapproach, 2020-02-14:
Yes you can use either one. Run line may be regulated but didn’t provade enough current all the time.

VincentGijsen, 2021-06-05:
push https://github.com/VincentGijsen/melbus-sniffed-traffic/commit/59f7c61e5ae8cf85db9b7f11014d31fe805093a9  has 803 hu command logs (MDchanger)

Thread 25 (2019-11-03):

suggestion BT-module-upgrade

VincentGijsen, 2019-11-03:
Hi,

Long time. came accros the Microchip module (BM20), and this guy's repo: [https://github.com/tomaskovacik/arduino ](https://github.com/tomaskovacik/arduino)

These modules also support meta-data and are rather cheap (EURO 6,90 before tax-shipping) and can be purchased single pieces at microchipdirect.com

@tomaskovacik also sells breakout-boards to make it more comfortable to work with the small BT-module: [https://www.tindie.com/products/tomaskovacik/bm20-breadboard-adapter/](https://www.tindie.com/products/tomaskovacik/bm20-breadboard-adapter/)

I just placed order for BM20 and the breakoutboard (so no hands-on experience yet)

disclaimer: i'm not affiliated in any way, just like the guys efforts and open-sourcing

everything(hardware + software).

i'm thinking about moving to a STM32103 (aka 'blue-pill') and use freertos. than i might implement lcd-scrolling in software (as i havent encountered the particular melbus-flag)

cheers,
Vincent

tomaskovacik, 2019-11-04:
actual library is here: https://github.com/tomaskovacik/IS2020
avrcp is not complete ..

visualapproach, 2019-11-04:
Cool!

VincentGijsen, 2020-01-26:
Hi,
small update
the stated module supports among others AVRCP1.5 and raw-AVRCP commands. with that, i'm able to extract all kind of nifty details.

currently working:
- song-meta info (album/artist/title/length), extracted
- playback-position,
- player-control (spotify)
- event handling
- various details like phone-battery, capacity,
- signal strength, roaming status

likely to get working:
- do navigation of song-repository
- cover art (not so usefull on our volvo radio's)
- phone-book /contact support
 various other stuff

It uses a uart interface, so hardware-wise not so messy as binary contacts, however software wise quite a bit more complex, with keeping states.

my current software is here https://github.com/VincentGijsen/MelbusRtos should you be interested, however still very rough, no melbus-code implemented yet but as we know how that must work, it just work-ahead, now i focused primarily on getting al bluetooth functions available, and a practical means to test the UI, which i simulate using the usb-stack with vcp on the STM32f bluepill. i'm using FreeRTOS to keep all the tasks /housekeeping separated.

tomaskovacik, 2020-03-23:
guys, I just tested BM62 module which compatible with BM20 (pins and serial protocol), it is flash-based so future firmware upgrades are possible (BM20 is ROM)

there are also some sources  for pic micros in C, for inspiration
https://www.microchip.com/wwwproducts/en/BM62

Thread 26 (2019-12-18):

Creeping line on the screen HU

assa62, 2019-12-18:
Thanks to the author for the wonderful code with which we can connect BT to our devices. I came across BT that displays track data in the serial port. Here is a little finalized. https://youtu.be/w6zfiRrXcH0
Thanks!

visualapproach, 2019-12-18:
Awesome! Thanks for the kind words. Do you do the scrolling by updating the text very often or did you find a nicer way?

assa62, 2019-12-18:
I can’t defeat the melbus, but I can insert such a piece into your code
`
void setCustomText() {
  byte tmp;
  tmp = customText[textRow - 1][0];
  for (int i = 0; i < 36 - 1; i++)
    customText[textRow - 1][i] = customText[textRow - 1][i + 1];
  customText[textRow - 1][36 - 1] = tmp;
}`

visualapproach, 2019-12-18:
Great, good work!

Murat8684, 2020-01-18:
Hi
aforementioned how do i add code Can you help.

assa62, 2020-01-19:
> Great, good work!

Hi. Can I post your code here with my improvements?

assa62, 2020-01-19:
> Hi
> aforementioned how do i add code Can you help.

Hi. In addition to the code, you must have a shield bluetooth with Rx/Tx

visualapproach, 2020-01-19:
> > Great, good work!
>
> Hi. Can I post your code here with my improvements?

Yes

assa62, 2020-01-19:
``/*
  New in this version:
    Hardwarewise - Adjusted pin numbers to match archi's PCB v2.0
    Softwarewise - Changed the way RGB LEDs are managed. Press "3" on HU to cycle through colors on driver side.
                    press "4" to do the same on passenger side. See github for more info.
                   Changed customText variable to hold four lines of text.
                   Battery voltage now only show one decimal. It's an estimate anyway.
                   Steering wheel "next/prev" is now working. (Same as pressing 2/6)
                   Switching to/from SAT source toggles a pin (A6). Can be used to turn of devices like the BT module. (github request)
                   (Not tested by me yet)

  Todo (someone): if possible, enable scrolling text. This should be possible since the text messages is larger than the screen.
  I guess scrolling can be turned on by
  1) editing some bits in the init messages
  2) editing some bits in the text headers
  3) some specific character combination in the text itself
  (Text IS scrolling twice after pressing source/sat display/ and choosing title/artist etc on the HU)

  By Thomas Landahl, 2018-10-16
  https://github.com/visualapproach/Volvo-melbus

  Comm sniffing and some code contribution by Vincent Gijsen. Thanks a LOT!

*/

#include <EEPROM.h>

#define INT_NUM (byte)1         //Interrupt number (0/1 on ATMega 328P)
#define MELBUS_CLOCKBIT (byte)3 //Pin D2  - CLK
#define MELBUS_DATA (byte)4     //Pin D3  - Data
#define MELBUS_BUSY (byte)5     //Pin D4  - Busy

/*const byte mutePin = 9;
  const byte playPin = 10;
  const byte prevPin = 11;
  const byte nextPin = 12;
  const byte upPin = 7;    //volume up (not used on PCB)
  const byte downPin = 8;  //volume down (not used on PCB)

  const byte LED_RED_LFT = 14;  //A0
  const byte LED_GRN_LFT = 15;  //A1
  const byte LED_BLU_LFT = 16;  //A2
  const byte LED_RED_RGT = 19;  //A3
  const byte LED_GRN_RGT = 18;  //A4
  const byte LED_BLU_RGT = 17;  //A5
*/
const byte MISC = 20;         //A6
const byte BATTERY = 21;      //A7 - PCB uses this
/*
  byte lftClr;
  byte rgtClr;
  String colors[8] = {
  "Black ", "Blue  ", "Green ", "Cyan  ", "Red   ", "Purple", "Yellow", "White "
  };
*/
const int R_CAR = 10; //cable resistance from battery to device
const int R_1 = 3300; //r1 of voltage divider (connected to GND)
const int R_2 = 6800; //r2 of voltage divider (connected to RAW)
const float T_LOSS = 0.8; //if circuit is protected with a transistor and diode, put total voltage drop here.

byte track = 0x01; //Display show HEX value, not DEC. (A-F not "allowed")
byte cd = 0x01; //1-10 is allowed (in HEX. 0A-0F and 1A-1F is not allowed)

//volatile variables used inside AND outside of ISP
volatile byte melbus_ReceivedByte = 0;
volatile byte melbus_Bitposition = 7;
volatile bool byteIsRead = false;

byte byteToSend = 0;          //global to avoid unnecessary overhead
bool reqMasterFlag = false;   //set this to request master mode (and sendtext) at a proper time.

#define RESPONSE_ID 0xC5      //ID while responding to init requests (which will use base_id)
#define BASE_ID 0xC0          //ID when getting commands from HU
#define MASTER_ID 0xC7

#define CDC_RESPONSE_ID 0xEE  //ID while responding to init requests (which will use base_id)
#define CDC_MASTER_ID 0xEF    //ID while requesting/beeing master
#define CDC_BASE_ID 0xE8      //ID when getting commands from HU
#define CDC_ALT_ID 0xE9       //Alternative ID when getting commands from HU

byte textHeader[] = {0xFC, 0xC6, 0x73, 0x01};
byte textRow = 2;
byte customText[4][36] = {
  {""},
  {"visualapproach"},
  {""},
  {""}
};

//HU asks for line 3 and 4 below at startup. They can be overwritten by customText if you change textRow to 3 or 4
byte textLine[4][36] = {
  {"Line 1"},           //is overwritten by init-sequence ("Volvo!")
  {"Line 2"},           //is overwritten by customText[1][]
  {"3=cycle L col"},    //changes if pressing 3-button
  {"4=cycle R col"}     //changes if pressing 4-button
};

const byte C1_Init_1[9] = {
  0x10, 0x00, 0xc3, 0x01,
  0x00, 0x81, 0x01, 0xff,
  0x00
};
const byte SO_C1_Init_1 = 9;

const byte C1_Init_2[11] = {
  0x10, 0x01, 0x81,
  'V', 'o', 'l', 'v', 'o', '!', ' ', ' '
};
const byte SO_C1_Init_2 = 11;

const byte C2_Init_1[] = {
  0x10, 0x01, 0xff, 0xff,
  0xff, 0xff, 0xff, 0xff,
  0xff, 0xff, 0xff, 0xff,
  0xff, 0xff, 0xff, 0xff,
  0xff, 0xff, 0xff
};
const byte SO_C2_Init_1 = 19;

const byte C3_Init_0[30] = {
  0x10, 0x00, 0xfe, 0xff,
  0xff, 0xdf, 0x3f, 0x29,
  0x2c, 0xf0, 0xde, 0x2f,
  0x61, 0xf4, 0xf4, 0xdf,
  0xdd, 0xbf, 0xff, 0xbe,
  0xff, 0xff, 0x03, 0x00,
  0xe0, 0x05, 0x40, 0x00,
  0x00, 0x00
} ;
const byte SO_C3_Init_0 = 30;

const byte C3_Init_1[30] = {
  0x10, 0x01, 0xff, 0xff,
  0xff, 0xff, 0xff, 0xff,
  0xff, 0xff, 0xff, 0xff,
  0xff, 0xff, 0xff, 0xff,
  0xff, 0xff, 0xff, 0xff,
  0xff, 0xff, 0xff, 0xff,
  0xff, 0xff, 0xff, 0xff,
  0xff, 0xff
};
const byte SO_C3_Init_1 = 30;

const byte C3_Init_2[30] = {
  0x10, 0x02, 0xff, 0xff,
  0xff, 0xff, 0xff, 0xff,
  0xff, 0xff, 0xff, 0xff,
  0xff, 0xff, 0xff, 0xff,
  0xff, 0xff, 0xff, 0xff,
  0xff, 0xff, 0xff, 0xff,
  0xff, 0xff, 0xff, 0xff,
  0xff, 0xff
};
const byte SO_C3_Init_2 = 30;

//Defining the commands. First byte is the length of the command.
#define MRB_1 {3, 0x00, 0x1C, 0xEC}            //Master Request Broadcast version 1
#define MRB_2 {3, 0x00, 0x1E, 0xEC}            //Master Request Broadcast version 2 (maybe this is second init seq?)
#define MI {3, 0x07, 0x1A, 0xEE}               //Main init sequence
#define SI {3, 0x00, 0x1E, 0xED}               //Secondary init sequence (turn off ignition, then on)
//changed from 00 1D ED

#define C1_1 {5, 0xC1, 0x1B, 0x7F, 0x01, 0x08} //Respond with c1_init_1
#define C1_2 {5, 0xC1, 0x1D, 0x73, 0x01, 0x81} //Respond with c1_init_2 (text)

#define C2_0 {4, 0xC2, 0x1D, 0x73, 0x00}       //Get next byte (nn) and respond with 10, 0, nn, 0,0 and 14 * 0x20 (possibly text)
#define C2_1 {4, 0xC2, 0x1D, 0x73, 0x01}       //Same as above? Answer 19 bytes (unknown)

#define C3_0 {4, 0xC3, 0x1F, 0x7C, 0x00}       //Respond with c1_init_2 (text)
#define C3_1 {4, 0xC3, 0x1F, 0x7C, 0x01}       //Respond with c1_init_2 (text)
#define C3_2 {4, 0xC3, 0x1F, 0x7C, 0x02}       //Respond with c1_init_2 (text)

#define C5_1 {3, 0xC5, 0x19, 0x73}  //C5, 19, 73, xx, yy. Answer 0x10, xx, yy + free text. End with 00 00 and pad with spaces

#define CMD_1 {3, 0xC0, 0x1B, 0x76}            //Followed by: [00, 92, FF], OR [01, 03 ,FF] OR [02, 05, FF]. Answer 0x10
#define PUP {4, 0xC0, 0x1C, 0x70, 0x02}      //Wait 2 bytes and answer 0x90?
#define CMD_3 {5, 0xC0, 0x1D, 0x76, 0x80, 0x00} //Answer: 0x10, 0x80, 0x92
#define PWR_OFF {6,0xC0, 0x1C, 0x70, 0x00, 0x80, 0x01} //answer one byte
#define PWR_SBY {6,0xC0, 0x1C, 0x70, 0x01, 0x80, 0x01} //answer one byte
#define IGN_OFF {3, 0x00, 0x18, 0x12}           //this is the last message before HU goes to Nirvana

#define BTN {4, 0xC0, 0x1D, 0x77, 0x81}        //Read next byte which is the button #. Respond with 3 bytes
#define NXT {5, 0xC0, 0x1B, 0x71, 0x80, 0x00}  //Answer 1 byte
#define PRV {5, 0xC0, 0x1B, 0x71, 0x00, 0x00}  //Answer 1 byte
#define SCN {4, 0xC0, 0x1A, 0x74, 0x2A}        //Answer 1 byte

#define CDC_CIR {3, CDC_BASE_ID, 0x1E, 0xEF}             //Cartridge info request. Respond with 6 bytes
#define CDC_TIR {5, CDC_ALT_ID, 0x1B, 0xE0, 0x01, 0x08}  //track info req. resp 9 bytes
#define CDC_NXT {5, CDC_BASE_ID, 0x1B, 0x2D, 0x40, 0x01} //next track.
#define CDC_PRV {5, CDC_BASE_ID, 0x1B, 0x2D, 0x00, 0x01} //prev track
#define CDC_CHG {3, CDC_BASE_ID, 0x1A, 0x50}             //change cd
#define CDC_PUP {3, CDC_BASE_ID, 0x19, 0x2F}             //power up. resp ack (0x00).
#define CDC_PDN {3, CDC_BASE_ID, 0x19, 0x22}             //power down. ack (0x00)
#define CDC_FFW {3, CDC_BASE_ID, 0x19, 0x29}             //FFW. ack
#define CDC_FRW {3, CDC_BASE_ID, 0x19, 0x26}             //FRW. ack
#define CDC_SCN {3, CDC_BASE_ID, 0x19, 0x2E}             //scan mode. ack
#define CDC_RND {3, CDC_BASE_ID, 0x19, 0x52}             //random mode. ack
#define CDC_NU {3, CDC_BASE_ID, 0x1A, 0x50}              //not used
//#define CDC_MI {0x07, 0x1A, 0xEE},         //main init seq. wait for BASE_ID and respond with RESPONSE_ID.
//#define CDC_SI {0x00, 0x1C, 0xED},         //secondary init req. wait for BASE_ID and respond with RESPONSE_ID.
//#define CDC_MRB {0x00, 0x1C, 0xEC}         //master req broadcast. wait for MASTER_ID and respond with MASTER_ID.

//This list can be quite long. We have approx 700 us between the received bytes.
const byte commands[][7] = {
  MRB_1,  // 0 now we are master and can send stuff (like text) to the display!
  MI,     // 1 main init
  SI,     // 2 sec init (00 1E ED respond 0xC5 !!)
  CMD_1,  // 3 follows: [0, 92, FF], OR [1,3 ,FF] OR [2, 5 FF]
  PUP,  // 4 wait 2 bytes and answer 0x90?
  MRB_2,  // 5 alternative master req bc
  CMD_3,  // 6 unknown. Answer: 0x10, 0x80, 0x92
  C1_1,   // 7 respond with c1_init_1
  C1_2,   // 8 respond with c1_init_2 (contains text)
  C3_0,   // 9 respond with c3_init_0
  C3_1,   // 10 respond with c3_init_1
  C3_2,   // 11 respond with c3_init_2
  C2_0,   // 12 get next byte (nn) and respond with 10, 0, nn, 0,0 and 14 of 0x20
  C2_1,   // 13
  C5_1,   // 14
  BTN,    // 15
  NXT,    // 16
  PRV,    // 17
  SCN,    // 18
  PWR_OFF,// 19
  PWR_SBY,// 20
  IGN_OFF, // 21
  CDC_CIR, // 22
  CDC_TIR, // 23
  CDC_NXT, // 24
  CDC_PRV, // 25
  CDC_CHG, // 26
  CDC_PUP, // 27
  CDC_PDN, // 28
  CDC_FFW, // 29
  CDC_FRW, // 30
  CDC_SCN, // 31
  CDC_RND, // 32
  CDC_NU   // 33
};

const byte listLen = 34; //how many rows in the above array

// some CDC (CD-CHANGER) data
byte trackInfo[] = {0x00, 0x02, 0x00, cd, 0x80, track, 0xC7, 0x0A, 0x02}; //9 bytes
byte startByte = 0x08; //on powerup - change trackInfo[1] & [8] to this
byte stopByte = 0x02; //same on powerdown
byte cartridgeInfo[] = {0x00, 0xFC, 0xFF, 0x4A, 0xFC, 0xFF};

String input_string = "";

/*
 *      **** SETUP ****
*/

void setup() {
  //Disable timer0 interrupt. It's is only bogging down the system. We need speed!
  TIMSK0 &= ~_BV(TOIE0);

  //All lines are idle HIGH
  pinMode(MELBUS_DATA, INPUT_PULLUP);
  pinMode(MELBUS_CLOCKBIT, INPUT_PULLUP);
  pinMode(MELBUS_BUSY, INPUT_PULLUP);
  /*  pinMode(nextPin, OUTPUT);
    pinMode(prevPin, OUTPUT);
    pinMode(playPin, OUTPUT);
    digitalWrite(nextPin, LOW);
    digitalWrite(playPin, LOW);
    digitalWrite(prevPin, LOW);
  */
  //set analog pins A0 through A7 to output/off
  for (byte i = 14; i < 22; i++) {
    pinMode(i, OUTPUT);
    digitalWrite(i, LOW);
  }
  pinMode(BATTERY, INPUT);

  //Initiate serial communication to debug via serial-usb (arduino)
  //Better off without it.
  //Serial printing takes a lot of time!!
  Serial.begin(115200);
  Serial.println("Calling HU");

  //  recall(); //get stored states from EEPROM and output to the LED driver.

  //Activate interrupt on clock pin
  attachInterrupt(digitalPinToInterrupt(MELBUS_CLOCKBIT), MELBUS_CLOCK_INTERRUPT, RISING);

  //Call function that tells HU that we want to register a new device
  melbusInitReq();
}

/*        **************************************************

          MAIN LOOP

          **************************************************
*/

void loop() {
  static byte lastByte = 0;     //used to copy volatile byte to register variable. See below
  static long runOnce = 300000;     //counts down on every received message from HU. Triggers when it is passing 1.
  static long runPeriodically = 100000; //same as runOnce but resets after each countdown.
  static long strRun = 15000;
  static bool powerOn = true;
  static long HWTicks = 0;      //age since last BUSY switch
  static long ComTicks = 0;     //age since last received byte
  static long ConnTicks = 0;    //age since last message to SIRIUS SAT
  static long timeout = 1000000; //should be around 10-20 secs
  static byte matching[listLen];     //Keep track of every matching byte in the commands array

  //these variables are reset every loop
  byte byteCounter = 1;  //keep track of how many bytes is sent in current command
  byte melbus_log[99];  //main init sequence is 61 bytes long...
  bool BUSY = PIND & (1 << MELBUS_BUSY);

  HWTicks++;
  if (powerOn) {
    ComTicks++;
    ConnTicks++;
  } else {
    ComTicks = 1;
    ConnTicks = 1;
    //to avoid a lot of serial.prints when its 0
  }

  //check BUSY line active (active low)
  while (!BUSY) {
    HWTicks = 0;  //reset age

    //Transmission handling here...
    if (byteIsRead) {
      byteIsRead = false;
      lastByte = melbus_ReceivedByte; //copy volatile byte to register variable
      ComTicks = 0; //reset age
      melbus_log[byteCounter - 1] = lastByte;
      //Loop though every command in the array and check for matches. (No, don't go looking for matches now)
      for (byte cmd = 0; cmd < listLen; cmd++) {
        //check if this byte is matching
        if (lastByte == commands[cmd][byteCounter]) {
          matching[cmd]++;
          //check if a complete command is received, and take appropriate action
          if ((matching[cmd] == commands[cmd][0]) && (byteCounter == commands[cmd][0])) {
            byte cnt = 0;
            byte b1 = 0, b2 = 0;
            ConnTicks = 0;  //reset age

            switch (cmd) {

              //0, MRB_1
              case 0:
                //wait for master_id and respond with same
                while (!(PIND & (1 << MELBUS_BUSY))) {
                  if (byteIsRead) {
                    byteIsRead = false;
                    if (melbus_ReceivedByte == MASTER_ID) {
                      byteToSend = MASTER_ID;
                      SendByteToMelbus();
                      SendText(textRow);
                      //Serial.println("MRB1");
                      break;
                    }
                  }
                }
                //Serial.println("MRB 1");
                break;

              //1, MAIN INIT
              case 1:
                //wait for base_id and respond with response_id
                while (!(PIND & (1 << MELBUS_BUSY))) {
                  if (byteIsRead) {
                    byteIsRead = false;
                    if (melbus_ReceivedByte == BASE_ID) {
                      byteToSend = RESPONSE_ID;
                      SendByteToMelbus();
                    }
                    if (melbus_ReceivedByte == CDC_BASE_ID) {
                      byteToSend = CDC_RESPONSE_ID;
                      SendByteToMelbus();
                    }
                  }
                }
                //Serial.println("main init");
                break;

              //2, Secondary INIT
              case 2:
                while (!(PIND & (1 << MELBUS_BUSY))) {
                  if (byteIsRead) {
                    byteIsRead = false;
                    if (melbus_ReceivedByte == CDC_BASE_ID) {
                      byteToSend = CDC_RESPONSE_ID;
                      SendByteToMelbus();
                    }
                    if (melbus_ReceivedByte == BASE_ID) {
                      byteToSend = RESPONSE_ID;
                      SendByteToMelbus();
                    }
                  }
                }
                //Serial.println("2nd init");
                break;

              //CMD_1. answer 0x10
              case 3:
                // we read 3 different tuple bytes (0x00 92), (01,3) and (02,5), response is always 0x10;
                while (!(PIND & (1 << MELBUS_BUSY))) {
                  if (byteIsRead) {
                    byteIsRead = false;
                    cnt++;
                  }
                  if (cnt == 2) {
                    byteToSend = 0x10;
                    SendByteToMelbus();
                    break;
                  }
                }
                powerOn = true;
                //Serial.println("Cmd 1");
                break;

              //PUP. power on?
              case 4:
                // {0xC0, 0x1C, 0x70, 0x02} we respond 0x90;
                while (!(PIND & (1 << MELBUS_BUSY))) {
                  if (byteIsRead) {
                    byteIsRead = false;
                    cnt++;
                  }
                  if (cnt == 2) {
                    byteToSend = 0x90;
                    SendByteToMelbus();
                    break;
                  }
                }
                //Serial.println("power on");
                digitalWrite(MISC, HIGH);
                break;

              //MRB_2
              case 5:
                // {00 1E EC };
                //wait for master_id and respond with same
                while (!(PIND & (1 << MELBUS_BUSY))) {
                  if (byteIsRead) {
                    byteIsRead = false;
                    if (melbus_ReceivedByte == MASTER_ID) {
                      byteToSend = MASTER_ID;
                      SendByteToMelbus();
                      SendText(textRow);
                      //Serial.println("MRB2");
                      break;
                    }
                  }
                }
                //Serial.println("MRB 2");
                break;

              // CMD_3,  // 6 unknown. Answer: 0x10, 0x80, 0x92
              case 6:
                byteToSend = 0x10;
                SendByteToMelbus();
                byteToSend = 0x80;
                SendByteToMelbus();
                byteToSend = 0x92;
                SendByteToMelbus();
                //Serial.println("cmd 3");
                break;

              //C1_1,    7 respond with c1_init_1
              case 7:
                for (byte i = 0; i < SO_C1_Init_1; i++) {
                  byteToSend = C1_Init_1[i];
                  SendByteToMelbus();
                }
                //Serial.println("C1 1");
                break;

              //C1_2,   8 respond with c1_init_2 (contains text)
              case 8:
                for (byte i = 0; i < SO_C1_Init_2; i++) {
                  byteToSend = C1_Init_2[i];
                  SendByteToMelbus();
                }
                //Serial.println("C1_2");
                break;

              //  C3_0,    9 respond with c3_init_0
              case 9:
                for (byte i = 0; i < SO_C3_Init_0; i++) {
                  byteToSend = C3_Init_0[i];
                  SendByteToMelbus();
                }
                //Serial.println("C3 init 0");
                break;

              //C3_1,    10 respond with c3_init_1
              case 10:
                for (byte i = 0; i < SO_C3_Init_1; i++) {
                  byteToSend = C3_Init_1[i];
                  SendByteToMelbus();
                }
                //Serial.println("C3 init 1");
                break;

              //C3_2,   11 respond with c3_init_2
              case 11:
                for (byte i = 0; i < SO_C3_Init_2; i++) {
                  byteToSend = C3_Init_2[i];
                  SendByteToMelbus();
                }
                //Serial.println("C3 init 2");
                break;

              //   C2_0,    12 get next byte (nn) and respond with 10, 0, nn, 0,0 and (14 times 0x20)
              // possibly a text field?
              case 12:
                while (!(PIND & (1 << MELBUS_BUSY))) {
                  if (byteIsRead) {
                    byteIsRead = false;
                    byteToSend = 0x10;
                    SendByteToMelbus();
                    byteToSend = 0x00;
                    SendByteToMelbus();
                    byteToSend = melbus_ReceivedByte;
                    SendByteToMelbus();
                    byteToSend = 0x00;
                    SendByteToMelbus();
                    byteToSend = 0x00;
                    SendByteToMelbus();
                    byteToSend = 0x20;
                    for (byte b = 0; b < 14; b++) {
                      SendByteToMelbus();
                    }
                    break;
                  }
                }
                //Serial.print("C2_0");
                //Serial.println(melbus_ReceivedByte, HEX);
                break;

              //C2_1,    13 respond as 12
              case 13:
                while (!(PIND & (1 << MELBUS_BUSY))) {
                  if (byteIsRead) {
                    byteIsRead = false;
                    byteToSend = 0x10;
                    SendByteToMelbus();
                    byteToSend = 0x01;
                    SendByteToMelbus();
                    byteToSend = melbus_ReceivedByte;
                    SendByteToMelbus();
                    byteToSend = 0x00;
                    SendByteToMelbus();
                    byteToSend = 0x00;
                    SendByteToMelbus();
                    byteToSend = 0x20;
                    for (byte b = 0; b < 14; b++) {
                      SendByteToMelbus();
                    }
                    break;
                  }
                }
                //Serial.print("C2_1");
                //Serial.println(melbus_ReceivedByte, HEX);
                //включить блютус
                //Serial.println("SAT_PWR_ON");
                Serial.write("AT+CB\r\n");

                break;

              //C5_1
              case 14:
                while (!(PIND & (1 << MELBUS_BUSY))) {
                  if (byteIsRead) {
                    byteIsRead = false;
                    b1 = melbus_ReceivedByte;
                    break;
                  }
                }
                while (!(PIND & (1 << MELBUS_BUSY))) {
                  if (byteIsRead) {
                    byteIsRead = false;
                    b2 = melbus_ReceivedByte;
                    break;
                  }
                }
                byteToSend = 0x10;
                SendByteToMelbus();
                byteToSend = b1;
                SendByteToMelbus();
                byteToSend = b2;
                SendByteToMelbus();
                for (byte b = 0; b < 36; b++) {
                  byteToSend = textLine[b2 - 1][b];
                  SendByteToMelbus();
                }
                //Serial.print("C5_1");
                break;

              //BTN
              case 15:
                //wait for next byte to get CD number
                while (!(PIND & (1 << MELBUS_BUSY))) {
                  if (byteIsRead) {
                    byteIsRead = false;
                    b1 = melbus_ReceivedByte;
                    break;
                  }
                }
                byteToSend = 255; //0x00;  //no idea what to answer
                //but HU is displaying "no artist" for a short while when sending zeroes.
                //Guessing there should be a number here indicating that text will be sent soon.
                SendByteToMelbus();
                byteToSend = 255; //0x00;  //no idea what to answer
                SendByteToMelbus();
                byteToSend = 255; //0x00;  //no idea what to answer
                SendByteToMelbus();

                switch (b1) {
                  //0x1 to 0x6 corresponds to cd buttons 1 to 6 on the HU (650) (SAT 1)
                  //7-13 on SAT 2, and 14-20 on SAT 3
                  //button 1 is always sent (once) when switching to SAT1.
                  case 0x1:
                    //toggleOutput(LEDMISC1); //turn on/off one output pin.
                    //Not used since it will be triggered by setting SAT1
                    Serial.println("AT+CF"); // volume+
                    break;
                  case 0x2:
                    Serial.println("AT+CM00");  //unfortunately the steering wheel button equals btn #2
                    break;
                  case 0x3:
                    //                    cycleLeft(); //change LED color
                    break;
                  case 0x4:
                    //                    cycleRight(); //change LED color
                    break;
                  case 0x5:
                    //not used for the moment
                    Serial.println("AT+CE"); // volume-
                    break;
                  case 0x6:   //unfortunately the steering wheel button equals btn #6
                    infoTrack(); // при воспроизведении не из БТ можно получить информацию о треке
                    break;
                }
                Serial.print("you pressed CD #");
                Serial.println(b1);
                break;

              //NXT
              case 16:
                byteToSend = 0x00;  //no idea what to answer
                SendByteToMelbus();
                nextTrack();
                //Serial.println("NXT");
                break;

              //PRV
              case 17:
                byteToSend = 0x00;  //no idea what to answer
                SendByteToMelbus();
                prevTrack();
                //Serial.println("PRV");
                break;

              //SCN
              case 18:
                byteToSend = 0x00;  //no idea what to answer
                SendByteToMelbus();
                play();
                //Serial.println("SCN");
                break;

              //PWR OFF
              case 19:
                byteToSend = 0x00;  //no idea what to answer
                SendByteToMelbus();
                //Serial.println("Power down");
                Serial.write("AT+CB\r\n");
                powerOn = false;
                digitalWrite(MISC, LOW);
                break;

              //PWR SBY
              case 20:
                byteToSend = 0x00;  //no idea what to answer
                SendByteToMelbus();
                //Serial.println("Power stby");
                Serial.write("AT+CB\r\n");
                powerOn = false;
                break;

              //IGN_OFF
              case 21:
                //Serial.println("Ignition OFF");
                Serial.write("AT+CB\r\n");
                powerOn = false;
                break;

              //
              case 22:
                SendCartridgeInfo();
                break;

              //
              case 23:
                SendTrackInfo();
                break;

              //
              case 24:
                track++;
                fixTrack();
                trackInfo[5] = track;
                nextTrack();
                break;

              //
              case 25:
                track--;
                fixTrack();
                trackInfo[5] = track;
                prevTrack();
                break;

              //
              case 26:
                changeCD();
                break;

              //CDC_PUP
              case 27:
                byteToSend = 0x00;
                SendByteToMelbus();
                trackInfo[1] = startByte;
                trackInfo[8] = startByte;
                digitalWrite(MISC, HIGH);
                break;

              //CDC_PDN
              case 28:
                byteToSend = 0x00;
                SendByteToMelbus();
                trackInfo[1] = stopByte;
                trackInfo[8] = stopByte;
                digitalWrite(MISC, LOW);
                break;

              //CDC_FFW
              case 29:
                byteToSend = 0x00;
                SendByteToMelbus();
                break;

              //CDC_FRW
              case 30:
                byteToSend = 0x00;
                SendByteToMelbus();
                break;

              //CDC_SCN
              case 31:
                byteToSend = 0x00;
                SendByteToMelbus();
                break;

              //CDC_RND
              case 32:
                byteToSend = 0x00;
                SendByteToMelbus();
                play();
                break;

              //CDC_NU
              case 33:

                break;

            } //end switch
            break;    //bail for loop. (Not meaningful to search more commands if one is already found)
          } //end if command found
        }
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

Thread 27 (2020-02-14):

HU buttons

Arroquw, 2020-02-14:
Hello,

Is it possible to receive the next and prev buttons from the HU with the melbus protocol? I'm planning to use a different bluetooth module (https://www.sunrom.com/get/996418), and it's possible to change tracks based on impedance with a button press, so I'm wondering if it's possible to hook up some resistors to arduino pins and write high to a digital pin if a button press if received.

Also, do I hook up the DIN shell ground to the bluetooth module or the audio common return?

Currently I have Karl Hagstrom's setup, with his code and an audio jack with cable. Im planning to add the bluetooth module and hook it up to the jack's switches, so it will use bluetooth if no jack is present.

visualapproach, 2020-02-14:
Gnd on DIN shell!
And yes you can use prev/next. It’s already  in the code (my code in this repository). You may need/want to adjust pin numbers in hw and/or sw and adapt to you specific build ofc. Good luck

Arroquw, 2020-02-14:
OH I kept thinking the 4066 components were physical buttons, but they are actually switch IC's. English is not my native language so I didn't know what bilateral means and assumed they meant something along the lines of physical. So D10-12 are used for play/next/prev buttons on the HU. I see.

By the way, what are the 100R resistances on CLK/BSY/DATA used for?

visualapproach, 2020-02-14:
Yes you are right about the 4066. Those resistors is not my idea, they seem to be ”good practice ”. They attenuate reflections probably.

Arroquw, 2020-02-16:
Alright. What kind of ground loop isolator should I use? The kind with 2 RCA connectors?

visualapproach, 2020-02-17:
That is up to you. I preferred small connectors but it is not important.

Closed 2020-04-06.

Thread 28 (2020-04-06):

popping sound

Arroquw, 2020-04-06:
Hello,

Currently instead of having a BT module connected, I have an AUX connector for testing. However I hear a constant popping sound, and if I connect the aux cable then it will be attenuated a bit. Ground loop isolator does not fix it. How can I fix this?

visualapproach, 2020-04-06:
I take it you’re not into pop;)

visualapproach, 2020-04-06:
Sorry, but I don’t know. Is it bursts of noise in equally spaced intervals?

Arroquw, 2020-04-07:
Yeah that's it

visualapproach, 2020-04-07:
Do you hear it whilst playing music?

Arroquw, 2020-04-07:
Yes, I hear it always. If nothing is connected, I hear it. If I dont play any music, I hear it. https://github.com/Arroquw/123 here's a video of the sound

visualapproach, 2020-04-07:
Ok, thanks for the video. It was some time now since I did this but it sound like the data signals coming through. Either by galvanic connection (a short somewhere) or by induction. There should be some comments regarding this on this page. Make sure you have only one GND wire connected to the arduino, to avoid a big loop antenna. Also make sure audio common return is not connected to GND.

visualapproach, 2020-04-07:
You could try this also:
https://github.com/visualapproach/Volvo-melbus/issues/19#issuecomment-426168662

Arroquw, 2020-04-07:
I tried the 4k7 resistors, no change at all. common return is not connected to GND either, I've tested that with a multimeter. There is also just the line from the transistor to the arduino as ground (you can see it in the video, it's the tin line going between the arduino pins). My friend also has a volvo and I've made this for him as well, but the board looks a lot different, he has the same problem but the popping is a bit louder.

Arroquw, 2020-04-10:
would a 10uF cap do anything useful on the audio common return or maybe L and r?

visualapproach, 2020-04-10:
Maybe a little but at the cost of also filtrering wanted audio. I Wish I could give you a solution but I can’t. People having this issue are apparantly using cheap BT modules or aux. I had noise too until switching to the CSR module. No guarantee given though. The noise is coming from data signals on melbus. Even of you disconnect your circuit you Will hear it because the HU itself is transmitting on the lines.

assa62, 2020-04-10:
> The noise is coming from data signals on melbus. Even of you disconnect your circuit you Will hear it because the HU itself is transmitting on the lines.

And there is. He's right.

Arroquw, 2020-04-10:
Is there a theory or explanation as to why the CSR fixes the noise?

assa62, 2020-04-11:
> Is there a theory or explanation as to why the CSR fixes the noise?

I think this is an arduino board problem. There are clicks even without a connected module.

visualapproach, 2020-04-11:
It’s clicking even without the arduino if you remove it after the audio input is opened.
Not a theory but some speculation: when nothing is connected the audio input is high impedance and high gain, meaning it will easily pick up inductive noise like data signals. Somehow the CSR manages to overcome that. Possibly by active noise cancelling or strong output?

Arroquw, 2023-11-06:
I can confirm that using a headphone amplifier completely negates the popping noise, likely the internal amplifier of the BT module achieves the same result.

Thread 31 (2022-02-04):

Pin 8 - Naviagation?

arcascomp, 2022-02-04:
Really keen to try this out, one thought - I believe the pin 8 on the RTI/Sat Nav/CD Changer port is for navigation announcements. I'm presuming this is mono instead of the usual left/right inputs that are used, but I'd like to think that audio sent to this pin would interrupt any audio being played on the HU for sat nav directions?

Anyone with enough tinkering capability able to test this? AFAIK all solutions that exist either hand made like this or off the shelf allow bluetooth music streaming and calls to be handled as if the phone is a CD Changer. If your phone receives a call and a mic has been set up, then the call can be handled handsfree as long as the head unit is switched to CD Changer. Also, any phone based navigation software such as WAZE will only work if the head unit is switched across to CD Changer. Having a phone call or sat nav directions cut in over any audio source would be completely awesome, but I don't really know how to achieve it.

I have a HU850 but no RTI installed on my XC70.

Cheers,

Craig

Thread 32 (2023-05-25):

Working code with text and buttons

pld360, 2023-05-25:
I recently bought an S60 with the HU-603 radio. I want to make an emulator for bluetooth. I would like for it to support text (so work as MD Changer as my radio doesn't have SAT source) and also controlling the bluetooth device  (next/prev steering wheel or radio buttons). Is there any working ready-made code and schematic that will make this happen? I am a total noob with coding so just looking for something that works and won't fry the radio. Thanks!

VincentGijsen, 2023-11-04:
today we sniffed the MD-changer logic in @https://github.com/Arroquw, Volvo HU803 (similar to 603), car with my old aftermarket emulator iMIV.

raw dumps can be found here: https://github.com/VincentGijsen/melbus-sniffed-traffic/tree/master/md

if you want to take a turn reversing :), or wait until https://github.com/Arroquw has managed to patch the SAT code for those models.

Arroquw, 2023-11-06:
working on my STM32 version first, will try to port the implementation of text once I get that working

Arroquw, 2023-12-08:
Sending text as MD CHGR working on my stm32, just need to add bluetooth now.

https://github.com/Arroquw/volvo_melbus_stm32

Arroquw, 2023-12-09:
I ported my MD CHGR code to this project: https://github.com/visualapproach/Volvo-melbus/pull/33

Don't think the CSR bluetooth module has text/serial support though

Thread 35 (2025-03-11):

Arduino seemengly died after a week of use

ananasjk, 2025-03-11:
Remade the contraption a couple of times and the final version was stable and worked fine for a week and now it doesnt work. It is still flashable but i cant make it talk to the headunit. Could the arduino die because i didnt use the 100 ohm resistors on clock, data and busy lines? And why did it die? Overvoltage?
