visualapproach/Volvo-melbus/(commit log)

2017-03-18 Add files via upload
    Rewrote the code. It is now much more readable and easier to improve.
    Changes:
    * All commands in an array, easy to change.
    * Turned off Timer0 to gain some speed and stability. The use of millis() etc had to be replaced.
    * Well commented, completely new main loop code.
2017-03-19 Updated 7a to 7b
    There was a flaw in the handling of connection status that should be taken care of now. (Fingers crossed)
2017-03-24 Arduino, BT, BT remote control
    Rebuilt hardware and enabled bluetooth audio. New functions: change songs from steering wheel and Head Unit. Tested and working. Erased some bugs and changed pins to get a nicer HW layout.
    [melbus_v7e.ino]
2017-03-27 Add PLAY/STOP on SCAN-button
    Add PLAY/STOP on SCAN-button
2017-04-14 updated schematics
2017-07-11 added a more complete schematics
2017-07-11 newest version
    software handles volume+ and - by pressing cd #1 and #2, but you need to connect those pins. There is little point in doing that though, since it only mutes/raises volume on the BT-module amplifier. Remind you to level shift the signal between arduino and bt module. (5v/3.3v)
2017-07-11 adjusted text and more complete schematics
2017-08-05 Added a capacitor
    Appears to make the device more stable.
2017-11-12 Emulates both SAT and CD-C
    Remote control audio (play/pause/next song/previous song)
    Optional - control arduino output pins by pushing buttons on Head Unit
2017-11-12 This is an example of how to connect everything
    You can use any transistor capable of around 500-1000 mA
2017-11-17 updated a command due to error in a special case
    [SAT_and_CDC.ino]
2018-01-03 battery voltage is displayed
    New in this version:
    Hardwarewise - added a voltage divider to measure car battery voltage.
    Softwarewise - battery voltage is displayed on line 2 and updated every 5-ish second.
2018-01-03 New schematics and code.
    Battery voltage monitor on HU display
2018-10-16 updated code for PCB and more
2018-10-22 how to make LED driver circuit
    Light up your feet with RGB-LEDs (Common anode) and this driver circuit. Control the color from the HU.
